shridattdudhat/Havaamaan_Yantra/README.md

# Havaamaan_Yantra
Havaamaan_Yantra AKA WeatherStation !!
