shridattdudhat/Havaamaan_Yantra/Ref/QingStation-main/doc/figures/digrams.pptx

North

South

North

South

Excitation

Direct

Echo

Distorsion

## Slide 2

North

South

North

South

## Slide 3

## Slide 4

Pitch (D)

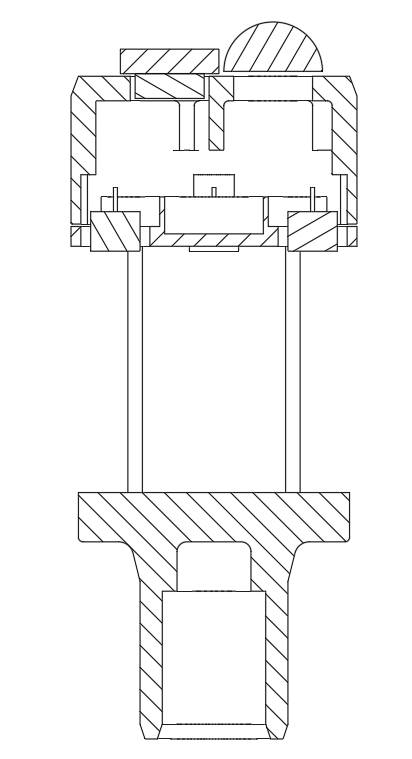
[picture p1: figure]

Silicone Glue

Transducers

α

Wind

Height
(H)

Sound travel path

B

A

Composition of motion

C

α

D

Reflector

## Slide 5

Transmitter

Receiver

Ideal Sound path

Pillars

Reflector

## Slide 6

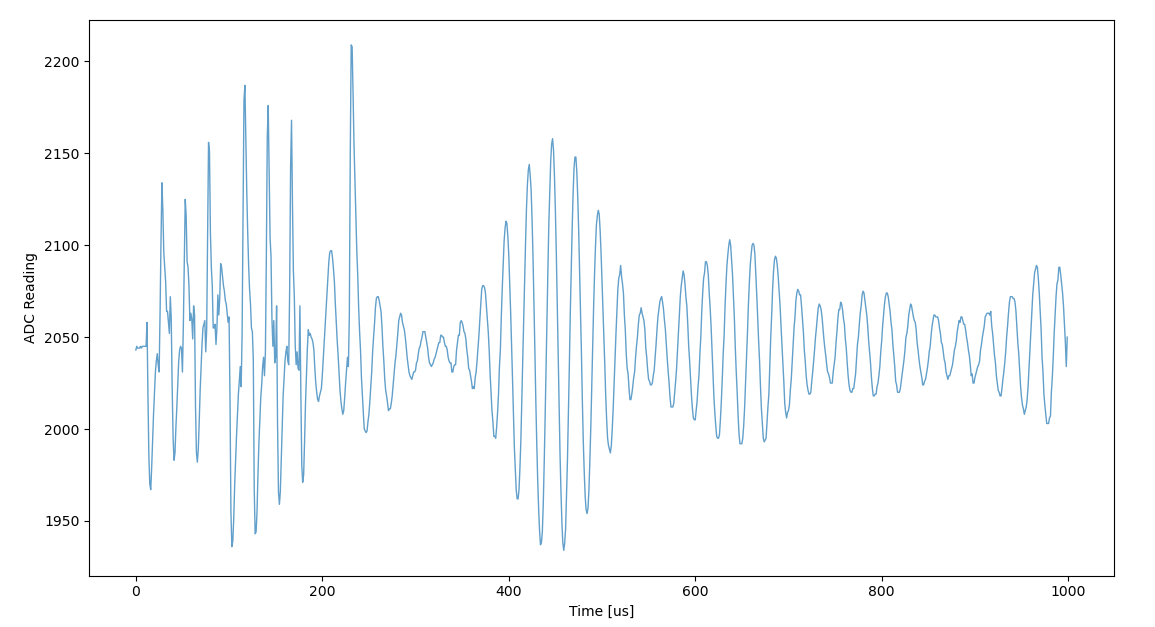
[picture p2: figure]

+

+

+

1st echo

2nd echo

3rd echo

## Slide 7

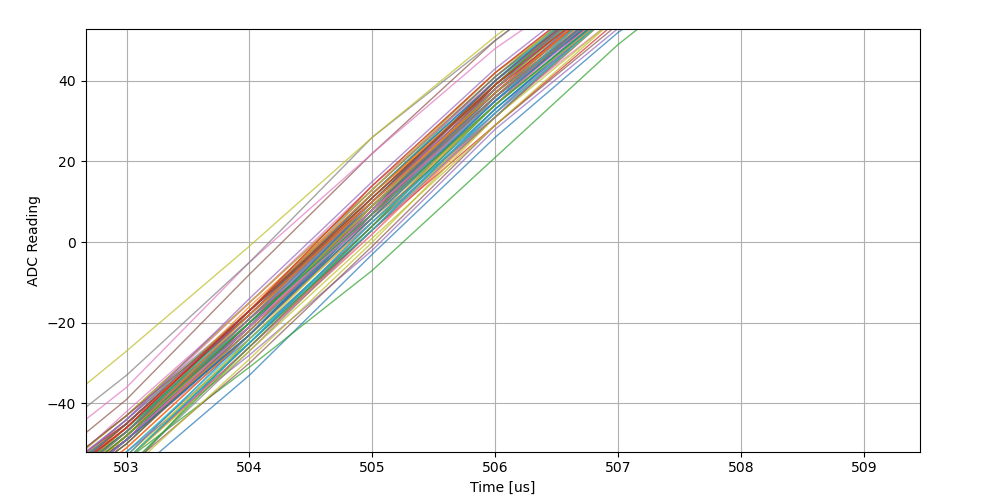
[picture p3: figure]
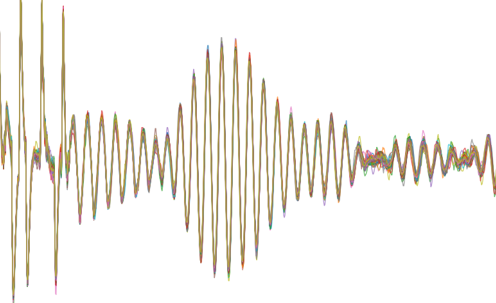
[picture p4: figure]

## Slide 8

## Slide 9

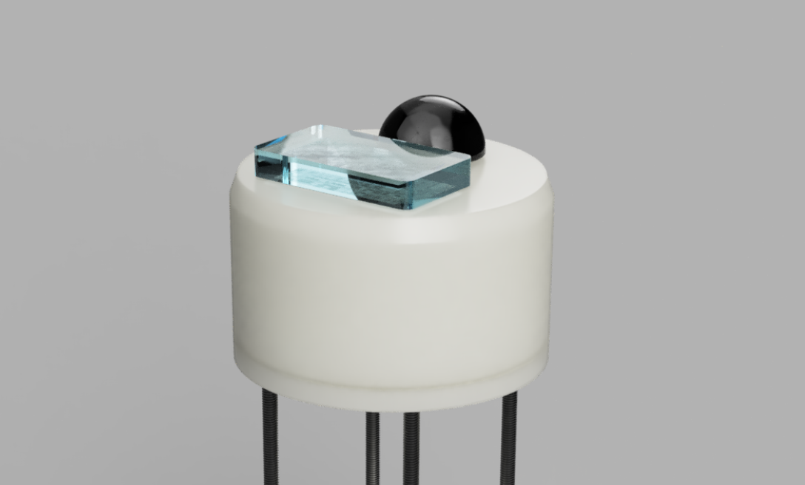
[picture p5: figure]

Rain Sensor

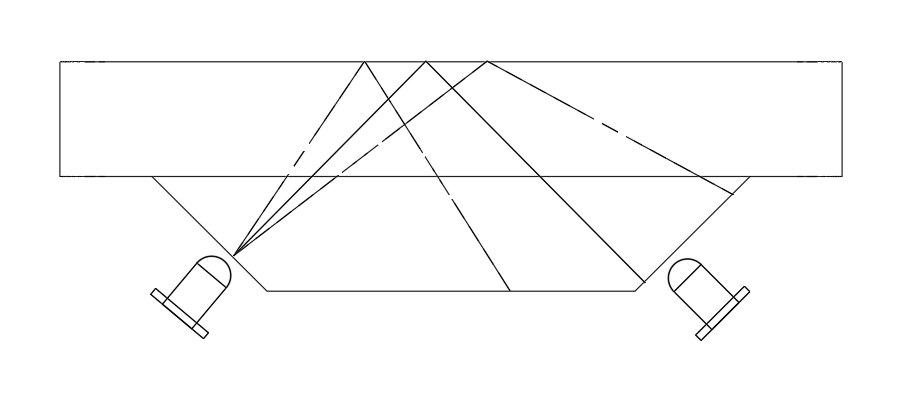
[picture p6: figure]

## Slide 10

Zone 1

Zone 2

## Slide 11

Single drops

## Slide 12

Light rain

## Slide 13

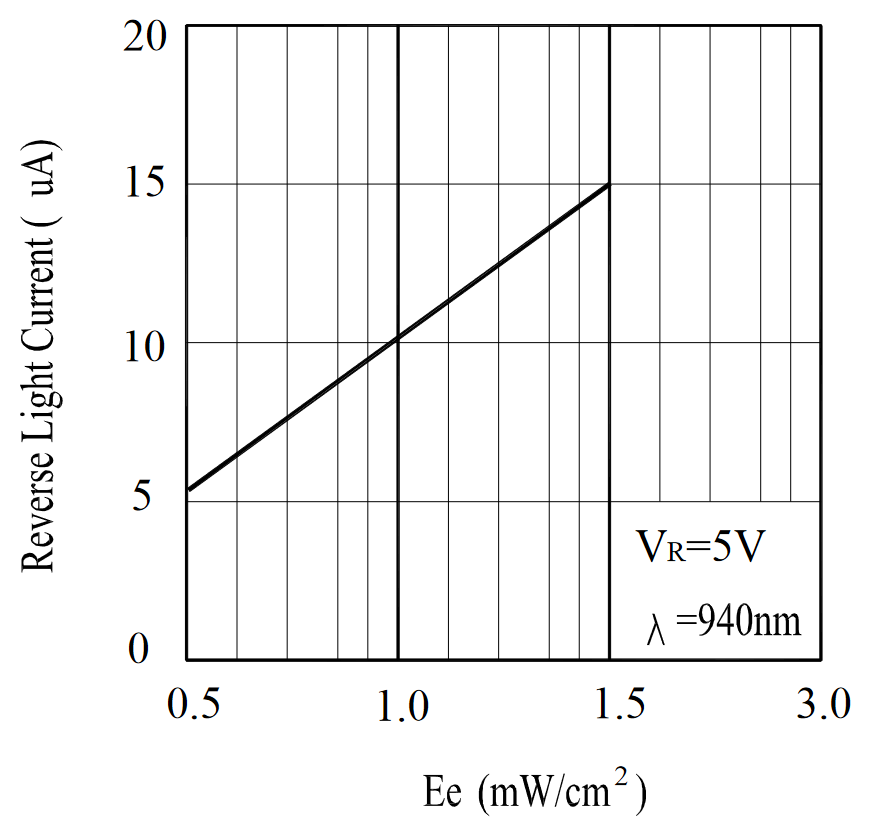
[picture p7: figure]
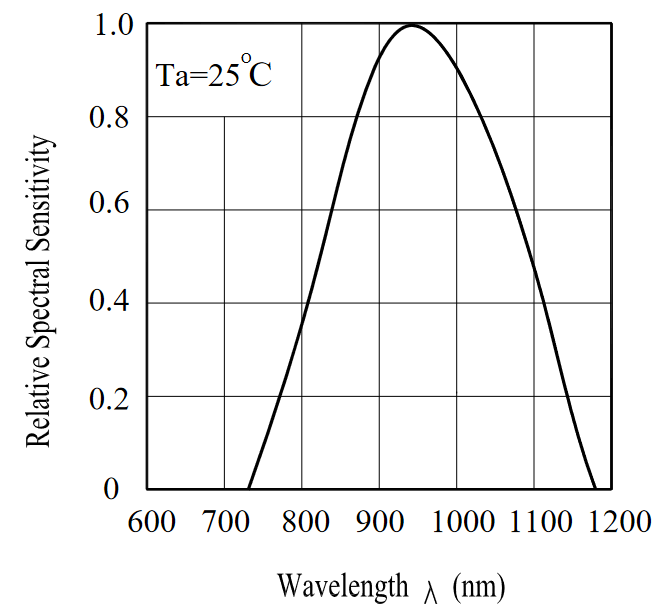
[picture p8: figure]

## Slide 14

Boot

Is App debug FM

Yes

No

SD card Boot

Key Pressed

SD Card Bin Search

Write to OTA and App

Validate App FM

Fail

No

Jump to App

Validate OTA FM

OTA != APP

Copy OTA to APP

Yes

No

Yes

## Slide 15

Bootloader
(64kB)

App Firmware
(446kB)

App tag
(2kB)

0x08000000

Flash bank 1

0x08010000

0x0807F800

OTA tag
(2kB)

OTA Firmware
(>446kB)

Reserve

0x08080000

Flash bank 2

0x08080800

?

0x0808FFFFF

## Slide 16

Initial

Type (8bit)

Firmware tag (str)

Data Pack

Type (8bit)

Pack ID (16b)

Size (16b)

Payload (N*8b)

Checksum(16b)

Close Pack

Type (8bit)

Payload (str)

Ack Pack

Type (8bit)

“pack id,true” or “pack id,false” (str)

## Slide 17

## Slide 18

## Slide 19
