shridattdudhat/Havaamaan_Yantra/Ref/QingStation-main/doc/figures/anemometer-sch.png

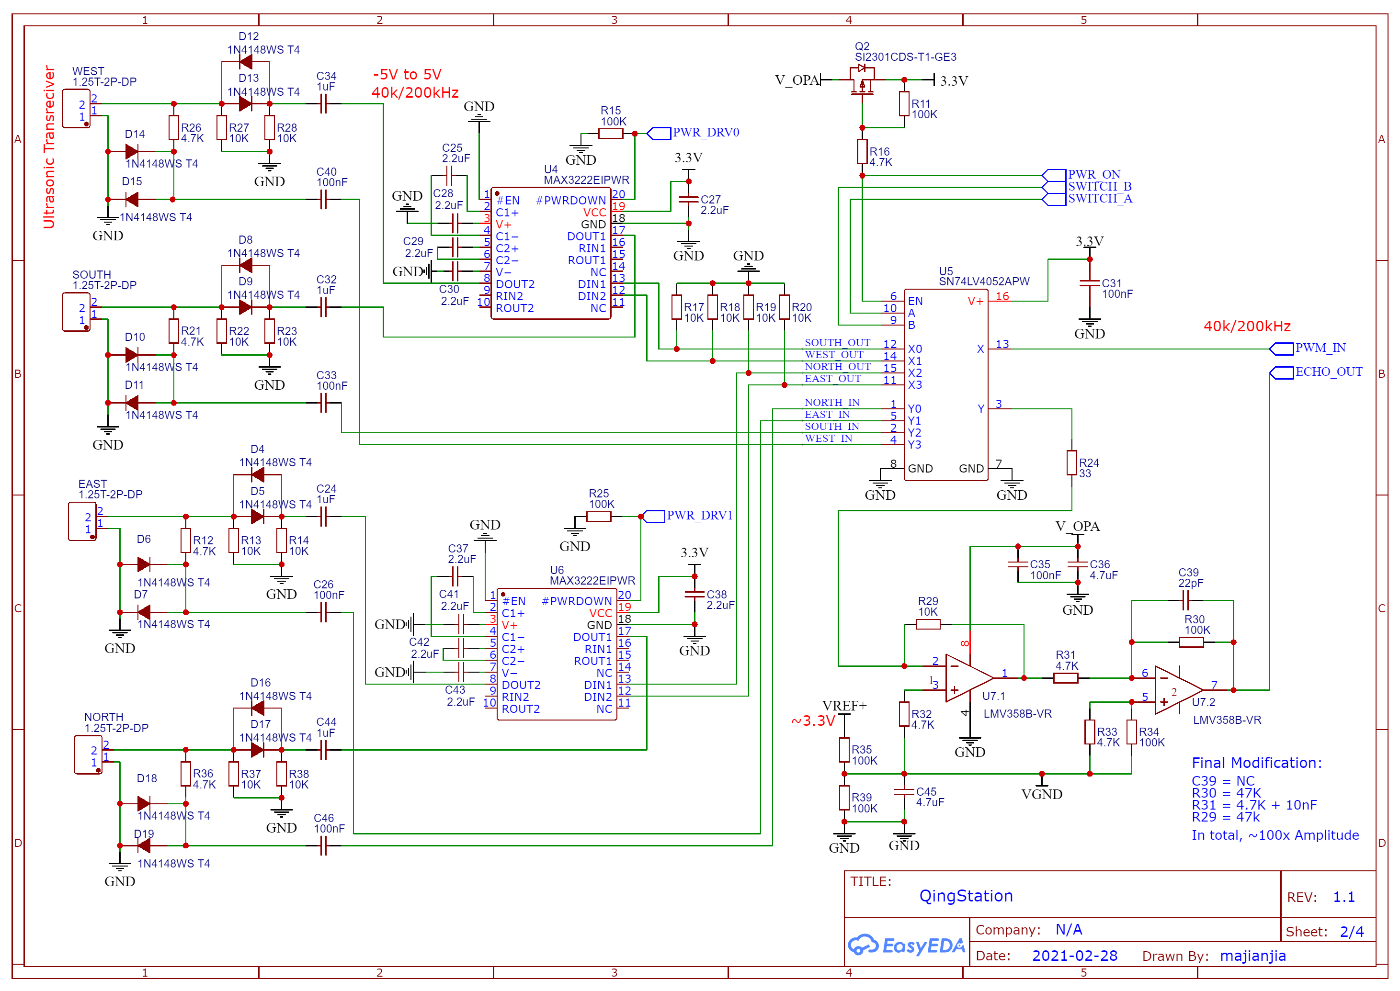
Ref/QingStation-main/doc/figures/anemometer-sch.png
