shridattdudhat/Havaamaan_Yantra/Ref/QingStation-main/doc/figures/anemometer_car_windspeed.png

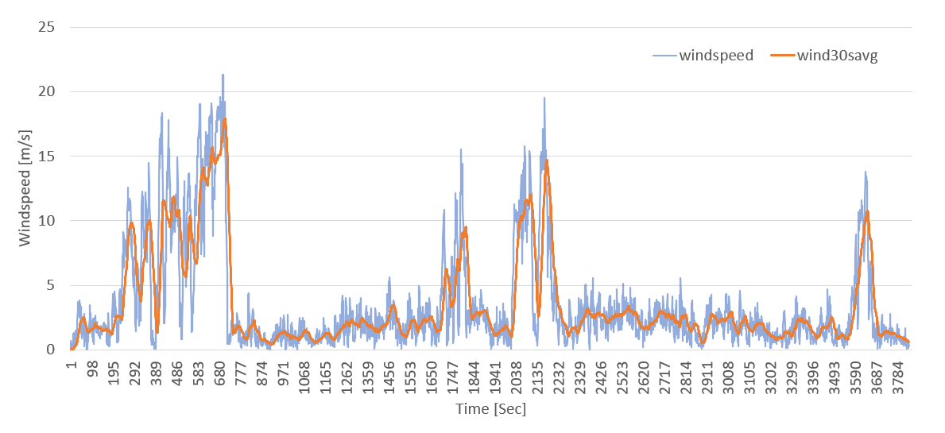
Ref/QingStation-main/doc/figures/anemometer_car_windspeed.png
