shridattdudhat/Havaamaan_Yantra/Ref/QingStation-main/doc/figures/anemometer_digital_filter_response.png

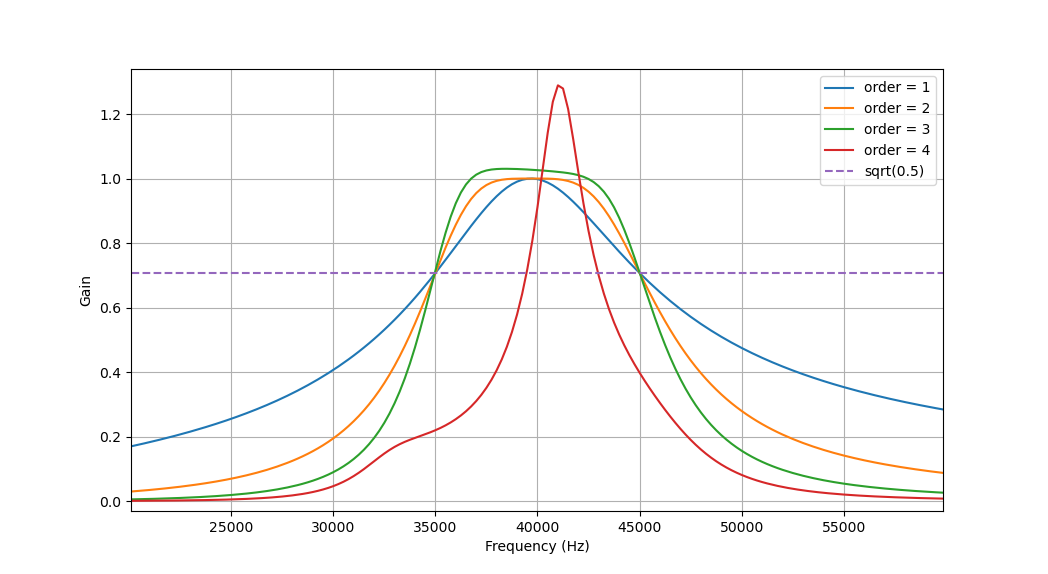
Ref/QingStation-main/doc/figures/anemometer_digital_filter_response.png
