shridattdudhat/Havaamaan_Yantra/Ref/QingStation-main/doc/figures/anemometer_excitation.png

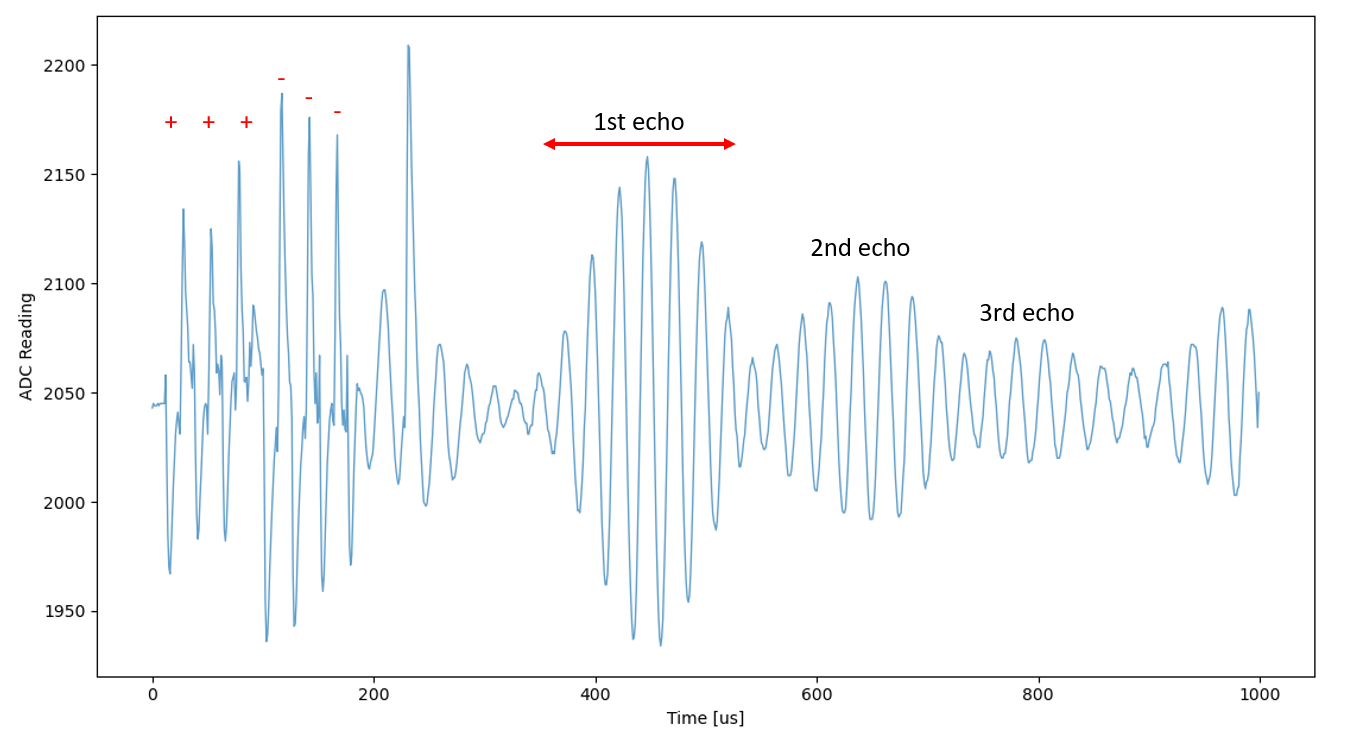
Ref/QingStation-main/doc/figures/anemometer_excitation.png
