shridattdudhat/Havaamaan_Yantra/Ref/QingStation-main/doc/figures/anemometer_final_beam.png

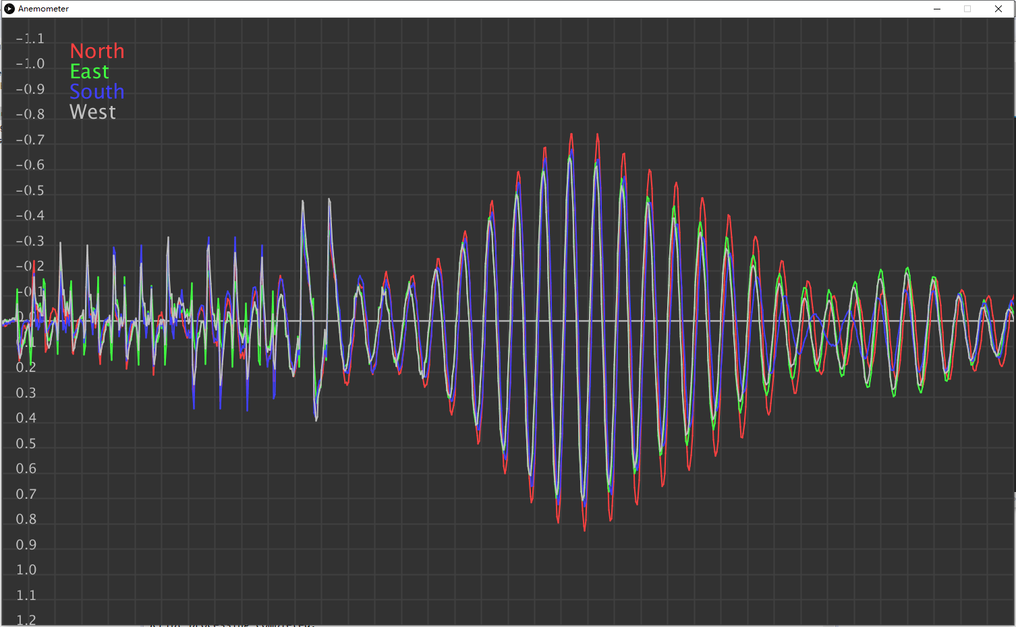
Ref/QingStation-main/doc/figures/anemometer_final_beam.png
