shridattdudhat/Havaamaan_Yantra/Ref/QingStation-main/doc/figures/anemometer_gnss_vs_wind.png

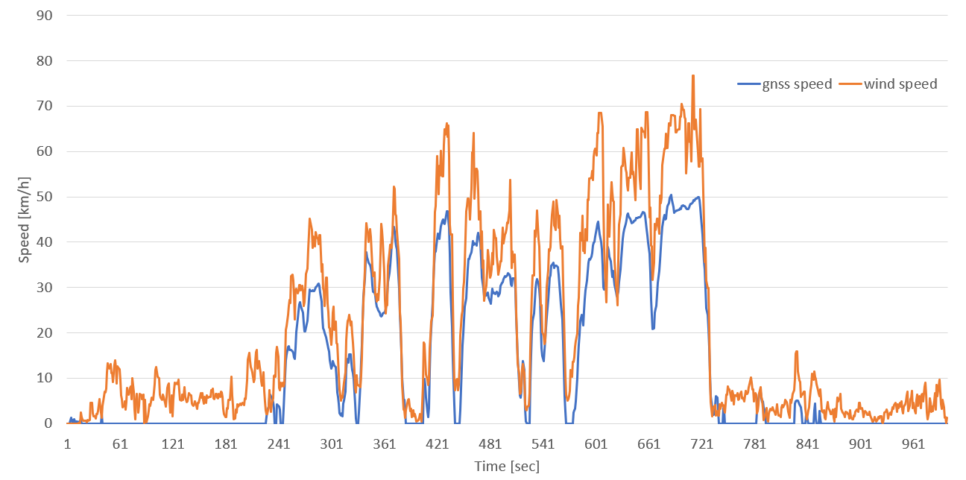
Ref/QingStation-main/doc/figures/anemometer_gnss_vs_wind.png
