shridattdudhat/Havaamaan_Yantra/Ref/QingStation-main/doc/figures/anemometer_keep_out_zone.png

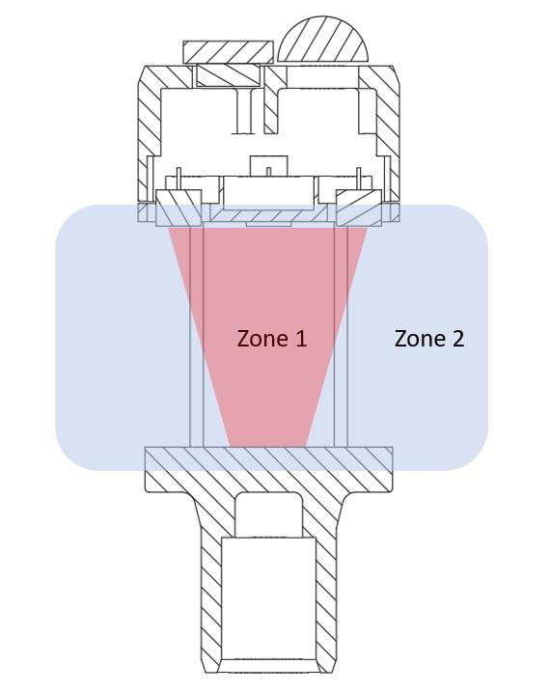
Ref/QingStation-main/doc/figures/anemometer_keep_out_zone.png
