shridattdudhat/Havaamaan_Yantra/Ref/QingStation-main/doc/figures/anemometer_motorway_rain.png

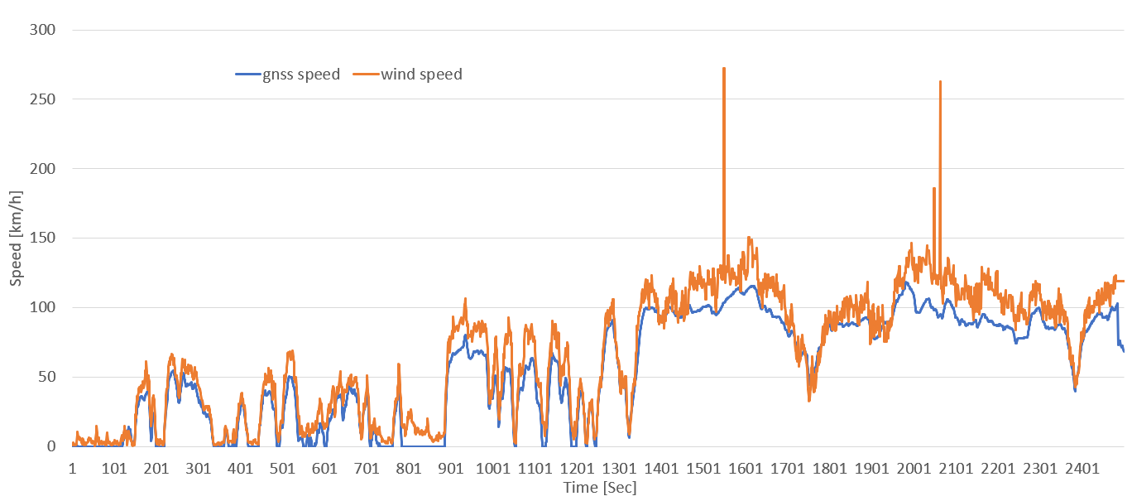
Ref/QingStation-main/doc/figures/anemometer_motorway_rain.png
