shridattdudhat/Havaamaan_Yantra/Ref/QingStation-main/doc/figures/anemometer_mse_threshold.png

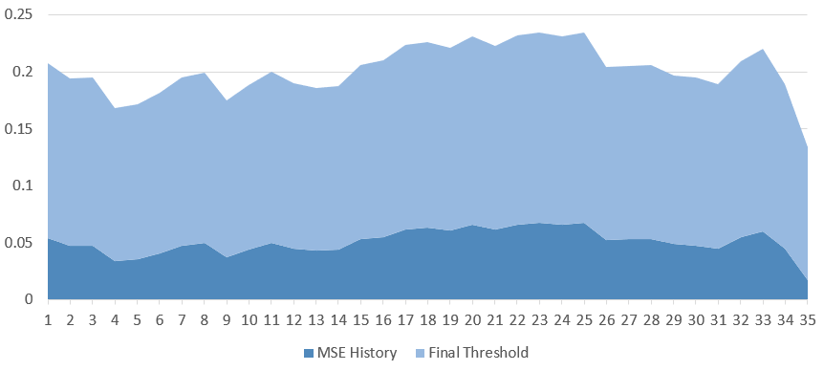
Ref/QingStation-main/doc/figures/anemometer_mse_threshold.png
