shridattdudhat/Havaamaan_Yantra/Ref/QingStation-main/doc/figures/anemometer_multiple_sound_path.png

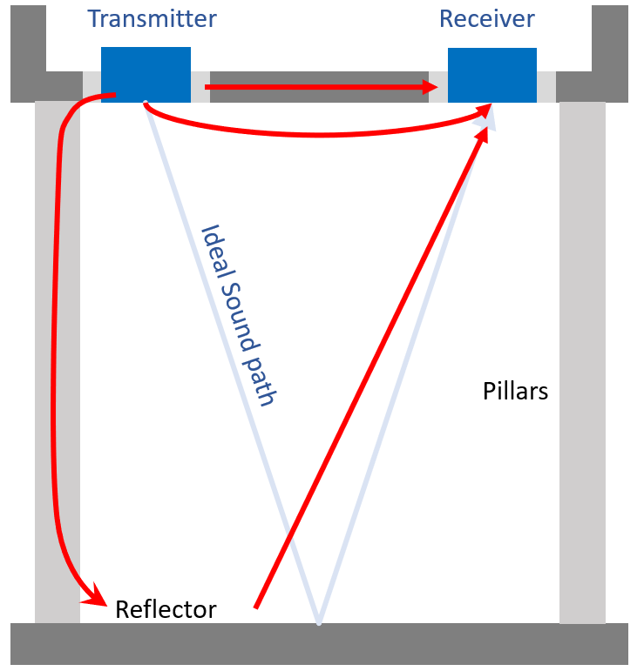
Ref/QingStation-main/doc/figures/anemometer_multiple_sound_path.png
