shridattdudhat/Havaamaan_Yantra/Ref/QingStation-main/doc/figures/anemometer_noise.png

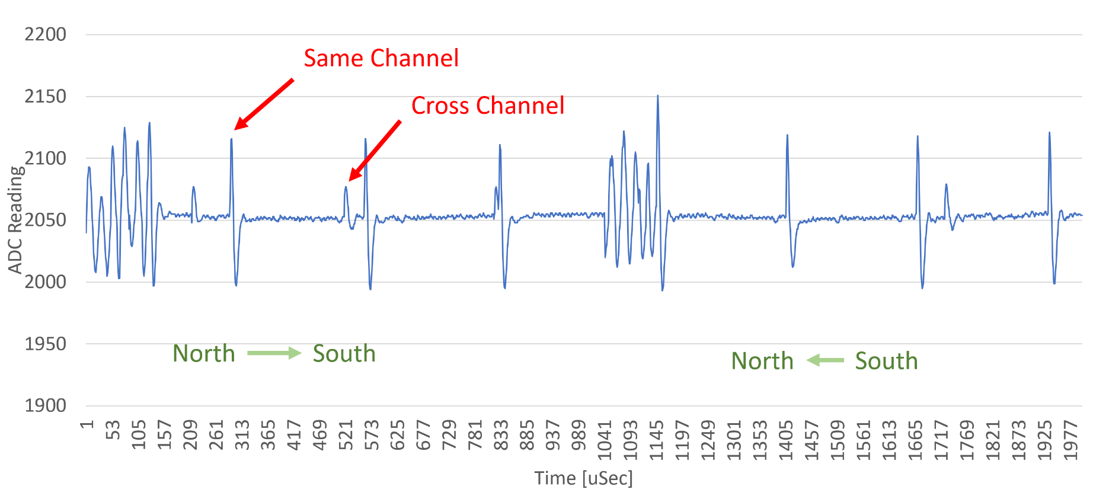
Ref/QingStation-main/doc/figures/anemometer_noise.png
