shridattdudhat/Havaamaan_Yantra/Ref/QingStation-main/doc/figures/anemometer_processing3_demo.gif

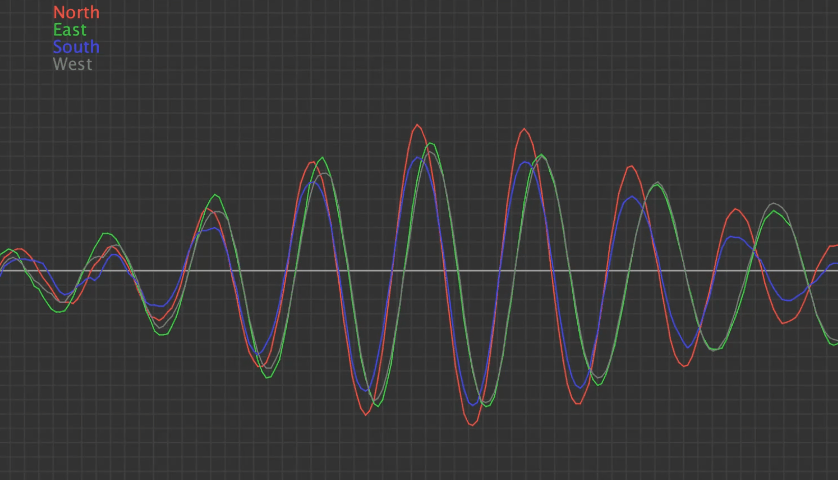
Ref/QingStation-main/doc/figures/anemometer_processing3_demo.gif
