shridattdudhat/Havaamaan_Yantra/Ref/QingStation-main/doc/figures/anemometer_signal_distorsion.png

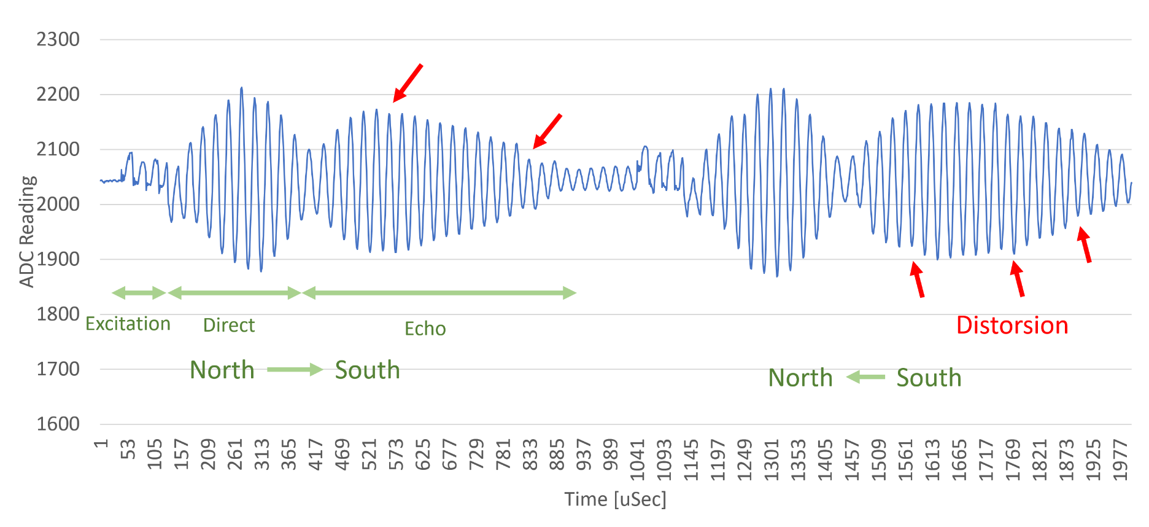
Ref/QingStation-main/doc/figures/anemometer_signal_distorsion.png
