shridattdudhat/Havaamaan_Yantra/Ref/QingStation-main/doc/figures/anemometer_speed_of_sound.png

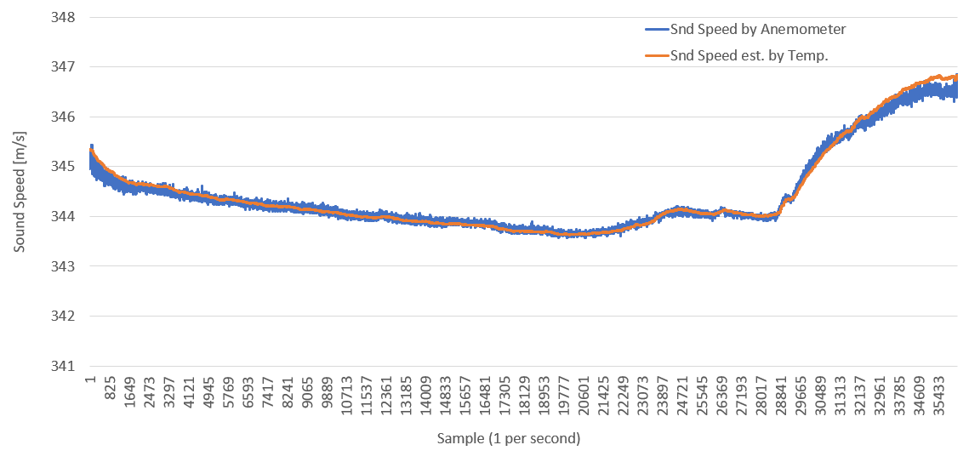
Ref/QingStation-main/doc/figures/anemometer_speed_of_sound.png
