shridattdudhat/Havaamaan_Yantra/Ref/QingStation-main/doc/figures/anemometer_wifi_power_burst2.png

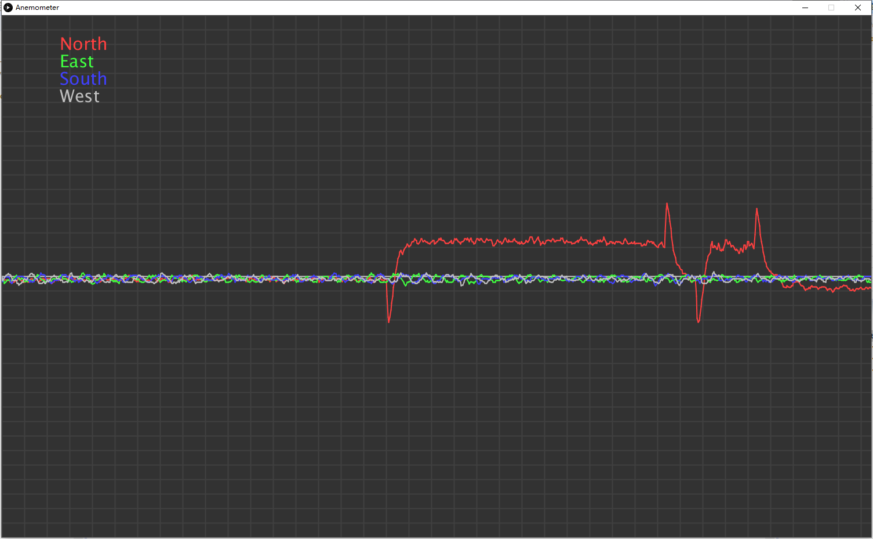
Ref/QingStation-main/doc/figures/anemometer_wifi_power_burst2.png
