shridattdudhat/Havaamaan_Yantra/Ref/QingStation-main/doc/figures/anemometer_wifi_power_burst.png

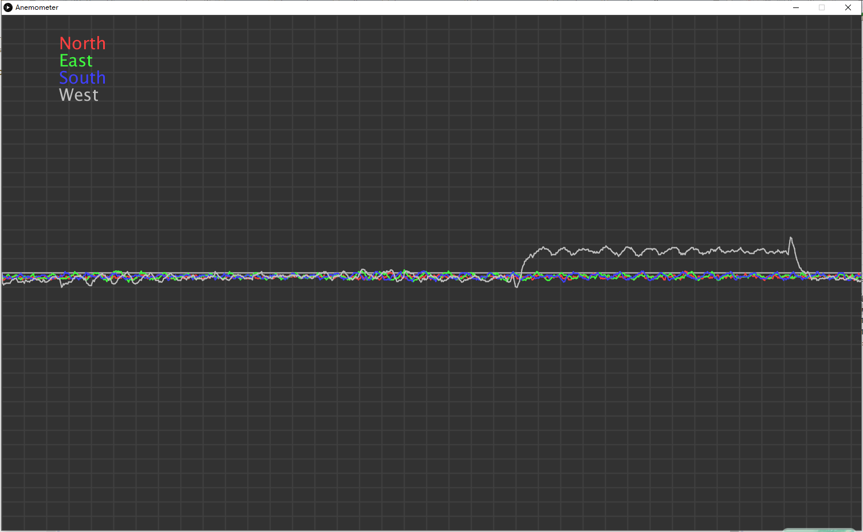
Ref/QingStation-main/doc/figures/anemometer_wifi_power_burst.png
