shridattdudhat/Havaamaan_Yantra/Ref/QingStation-main/doc/figures/anemometer_zero_offset_example.png

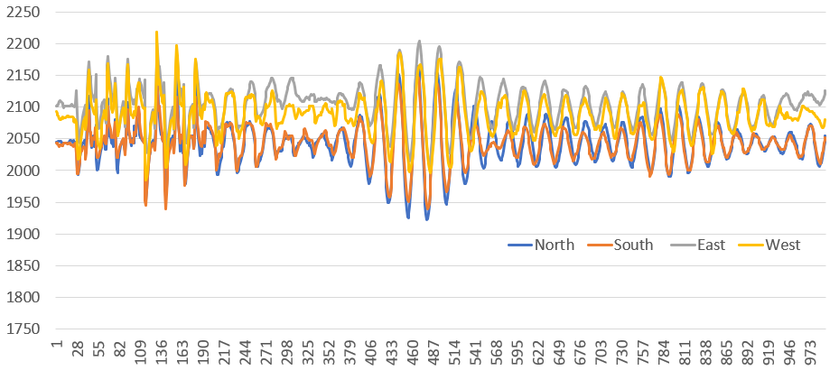
Ref/QingStation-main/doc/figures/anemometer_zero_offset_example.png
