shridattdudhat/Havaamaan_Yantra/Ref/QingStation-main/doc/figures/anemometer_zero_point.png

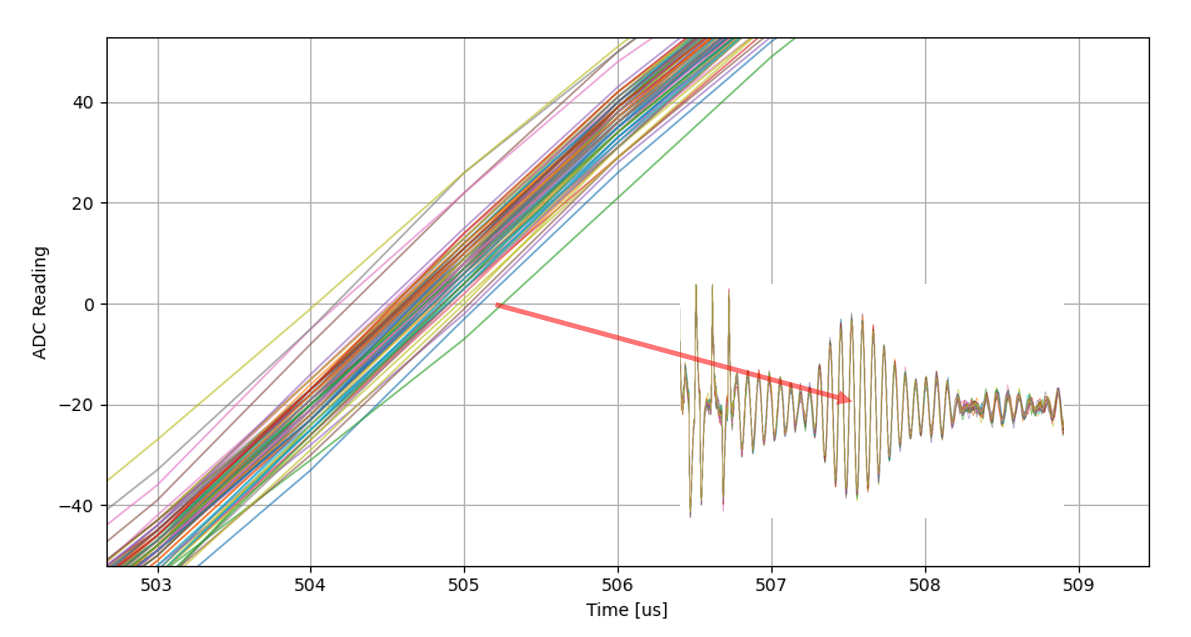
Ref/QingStation-main/doc/figures/anemometer_zero_point.png
