shridattdudhat/Havaamaan_Yantra/Ref/QingStation-main/doc/figures/as3935_noise.png

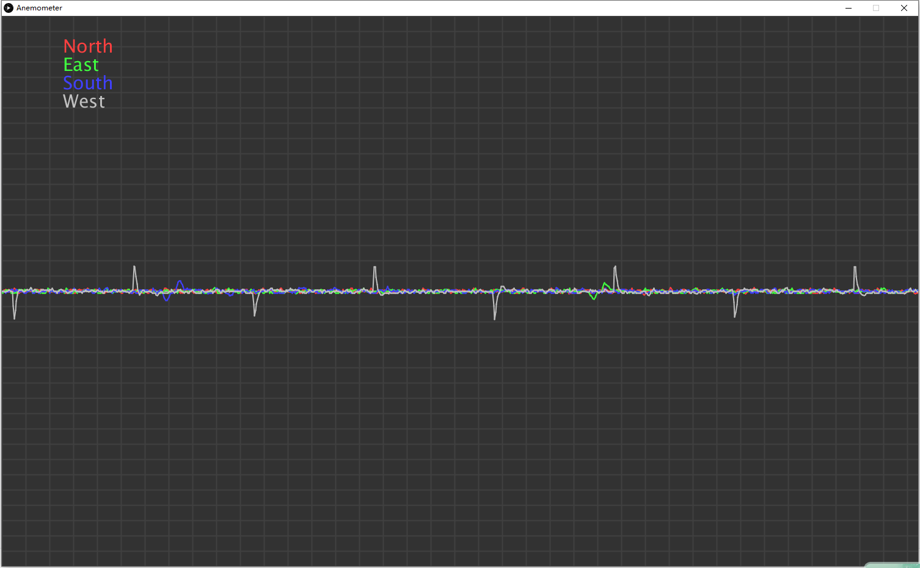
Ref/QingStation-main/doc/figures/as3935_noise.png
