shridattdudhat/Havaamaan_Yantra/Ref/QingStation-main/doc/figures/first_pulse_received.jpg

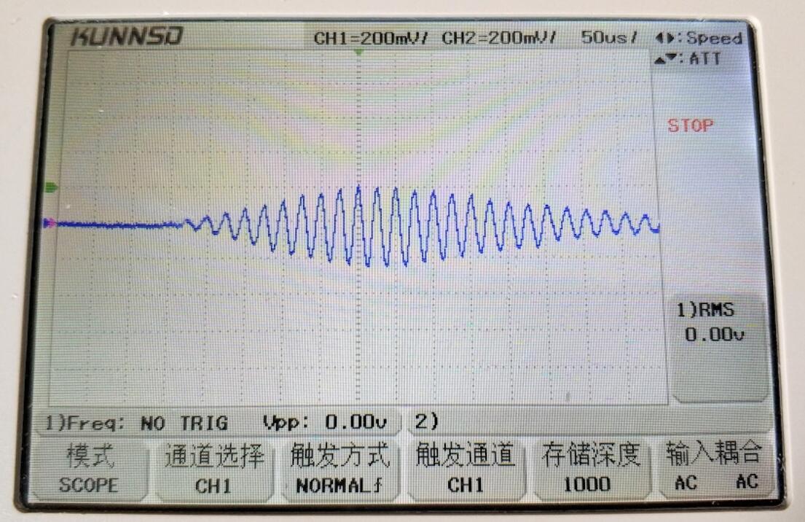
Ref/QingStation-main/doc/figures/first_pulse_received.jpg
