shridattdudhat/Havaamaan_Yantra/Ref/QingStation-main/doc/figures/imu_noise.png

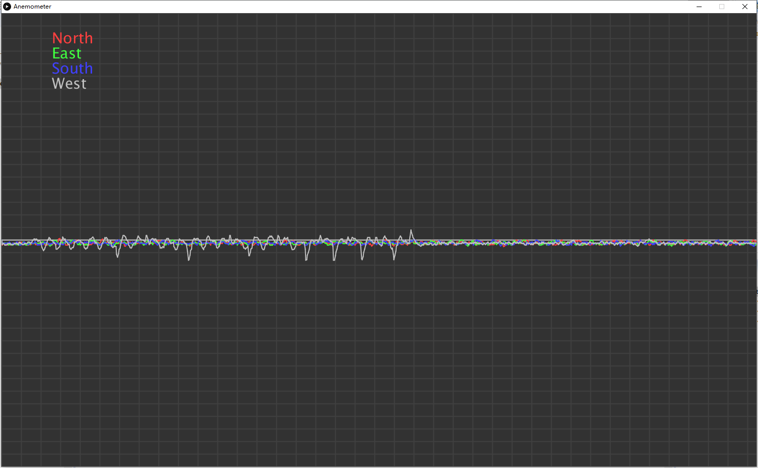
Ref/QingStation-main/doc/figures/imu_noise.png
