shridattdudhat/Havaamaan_Yantra/Ref/QingStation-main/doc/figures/max3232_driver_noise.jpg

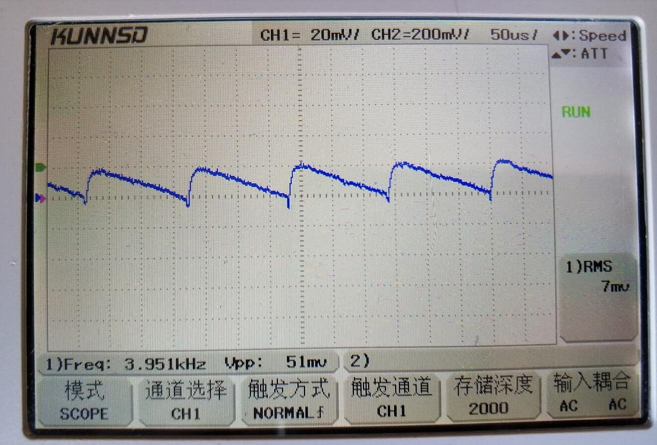
Ref/QingStation-main/doc/figures/max3232_driver_noise.jpg
