shridattdudhat/Havaamaan_Yantra/Ref/QingStation-main/doc/figures/ota_flash_allocation.png

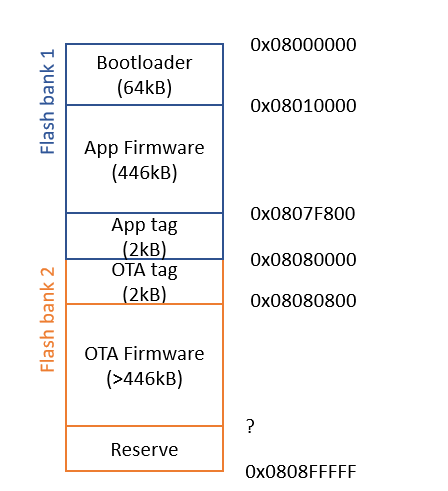
Ref/QingStation-main/doc/figures/ota_flash_allocation.png
