shridattdudhat/Havaamaan_Yantra/Ref/QingStation-main/doc/figures/ota_messages.png

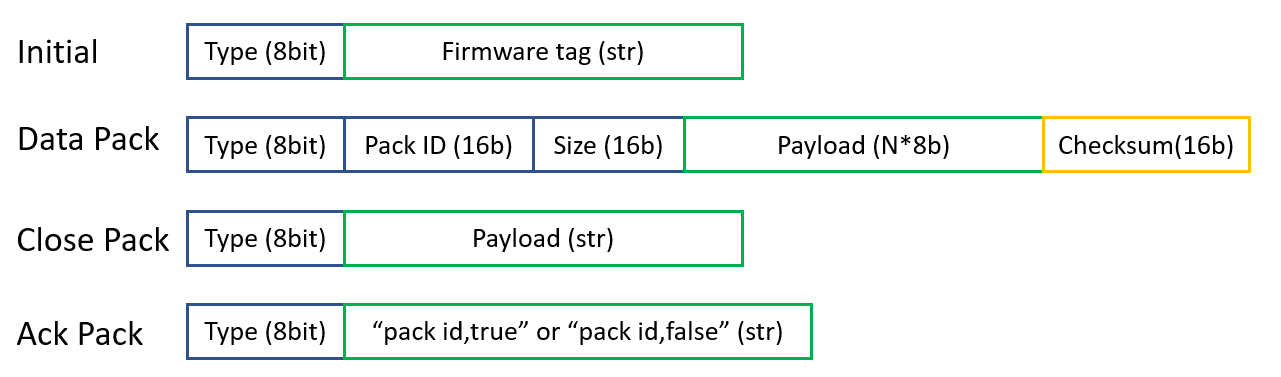
Ref/QingStation-main/doc/figures/ota_messages.png
