shridattdudhat/Havaamaan_Yantra/Ref/QingStation-main/doc/figures/QingStation-CDF2.png

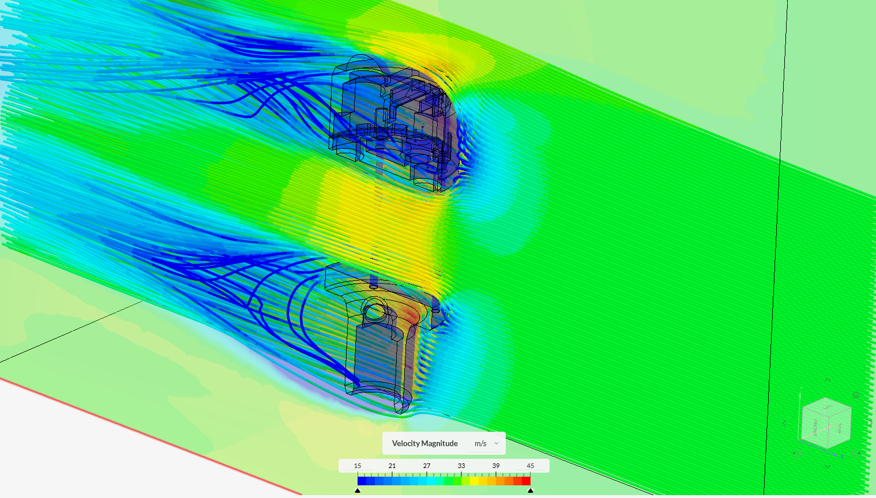
Ref/QingStation-main/doc/figures/QingStation-CDF2.png
