shridattdudhat/Havaamaan_Yantra/Ref/QingStation-main/doc/figures/QingStation-CDF.png

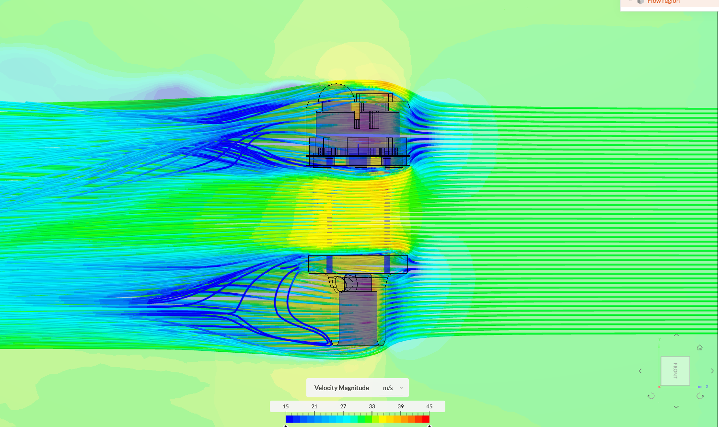
Ref/QingStation-main/doc/figures/QingStation-CDF.png
