shridattdudhat/Havaamaan_Yantra/Ref/QingStation-main/doc/figures/qingstation-render1.png

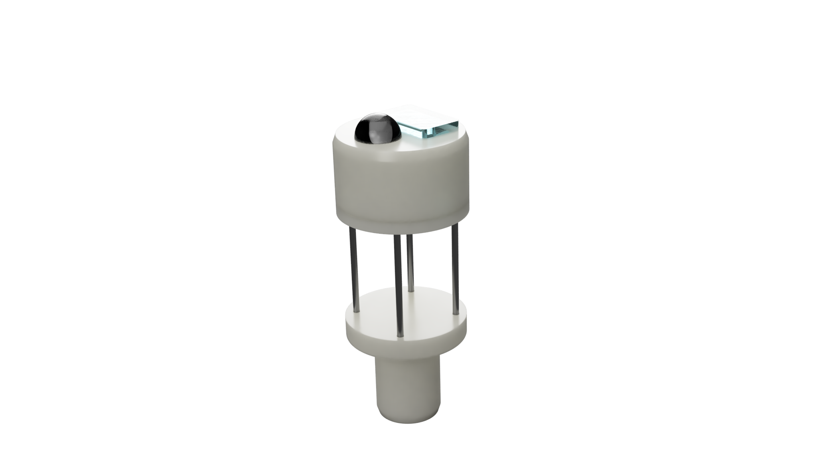
Ref/QingStation-main/doc/figures/qingstation-render1.png
