shridattdudhat/Havaamaan_Yantra/Ref/QingStation-main/doc/figures/qingstation-render2.PNG

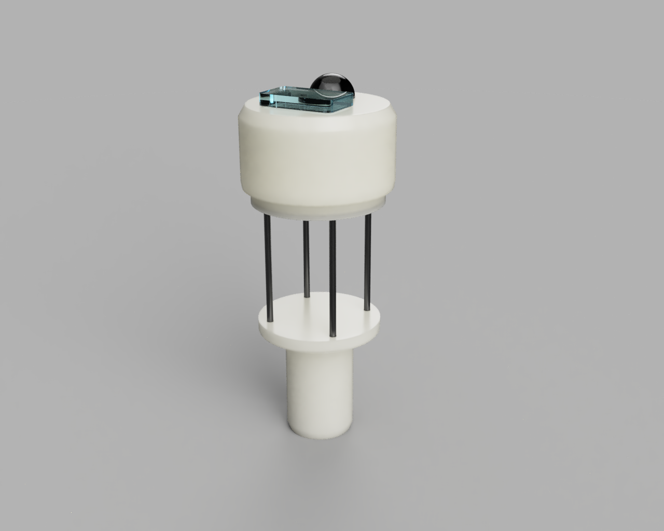
Ref/QingStation-main/doc/figures/qingstation-render2.PNG
