shridattdudhat/Havaamaan_Yantra/Ref/QingStation-main/doc/figures/rain_lens2.jpg

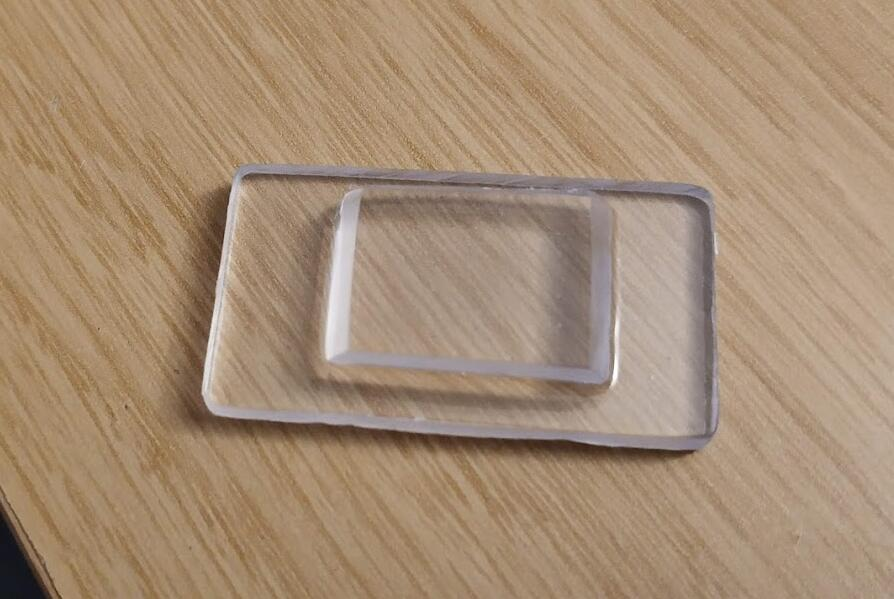
Ref/QingStation-main/doc/figures/rain_lens2.jpg
