shridattdudhat/Havaamaan_Yantra/Ref/QingStation-main/doc/figures/rain_lens.jpg

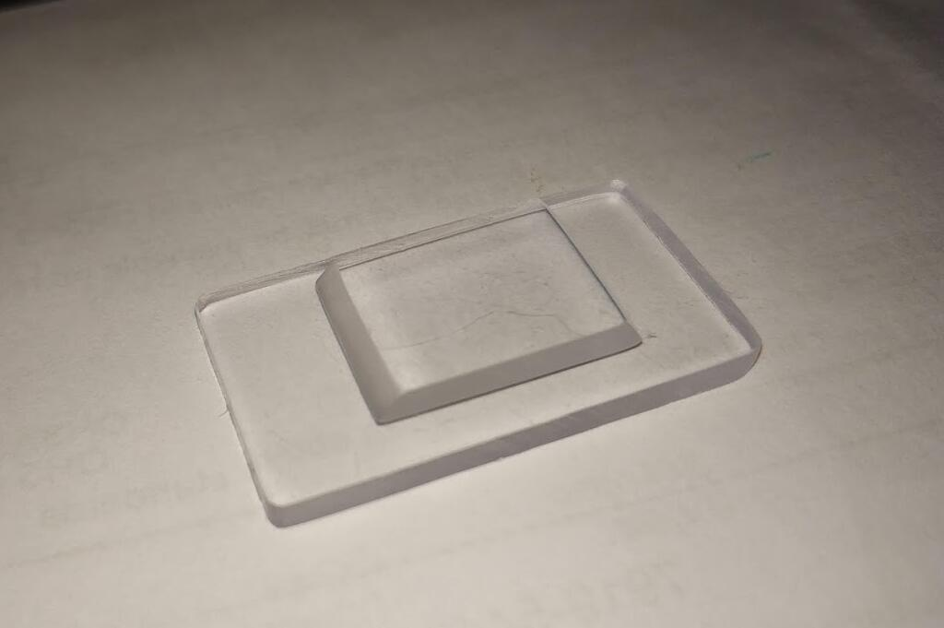
Ref/QingStation-main/doc/figures/rain_lens.jpg
