shridattdudhat/Havaamaan_Yantra/Ref/QingStation-main/doc/figures/rain_pd204 black.png

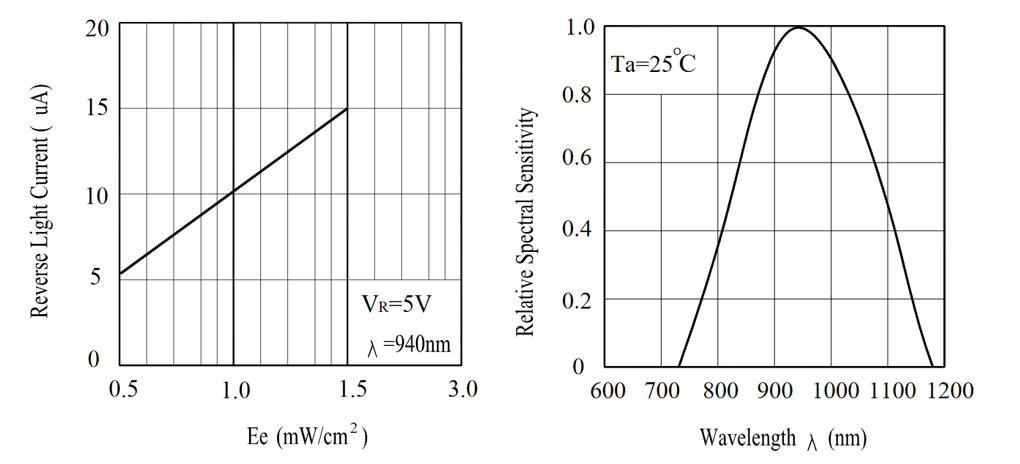
Ref/QingStation-main/doc/figures/rain_pd204 black.png
