shridattdudhat/Havaamaan_Yantra/Ref/QingStation-main/doc/figures/rain_realrain.png

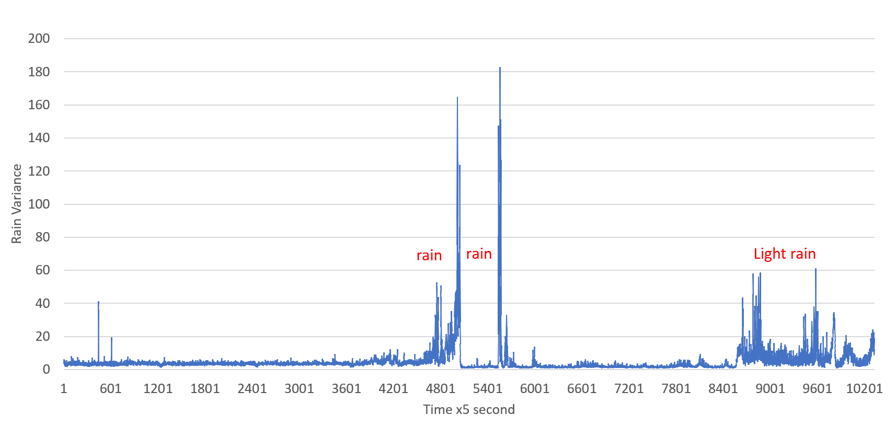
Ref/QingStation-main/doc/figures/rain_realrain.png
