shridattdudhat/Havaamaan_Yantra/Ref/QingStation-main/doc/figures/rain_schmatic.png

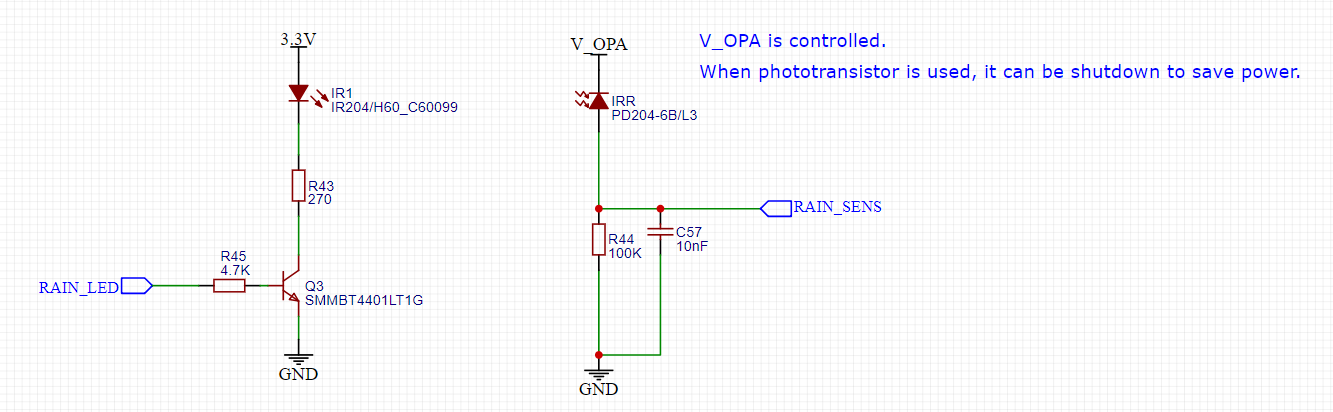
Ref/QingStation-main/doc/figures/rain_schmatic.png
