shridattdudhat/Havaamaan_Yantra/Ref/QingStation-main/doc/figures/rain_weather_forcast.jpg

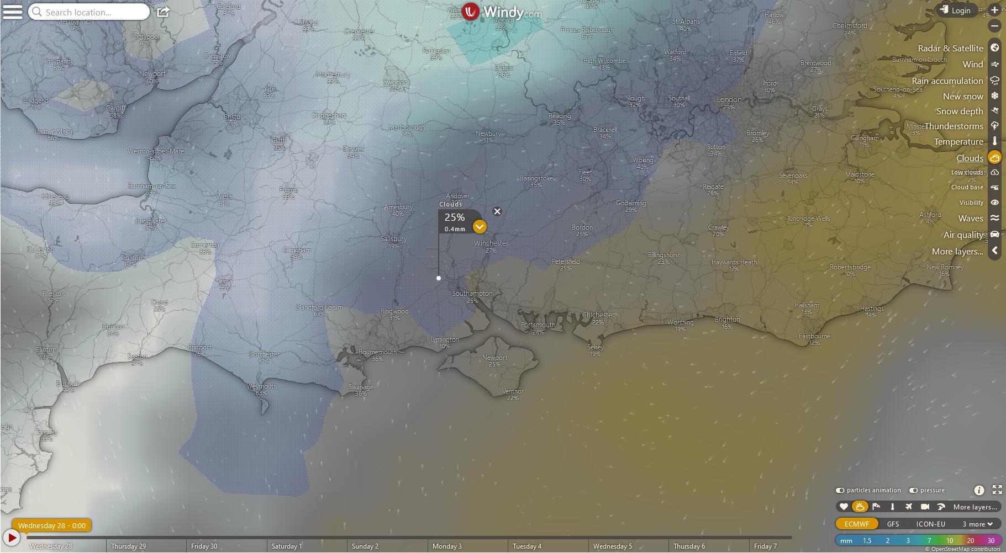
Ref/QingStation-main/doc/figures/rain_weather_forcast.jpg
