shridattdudhat/Havaamaan_Yantra/Ref/QingStation-main/doc/figures/ultrasonic_anemometer_principle.png

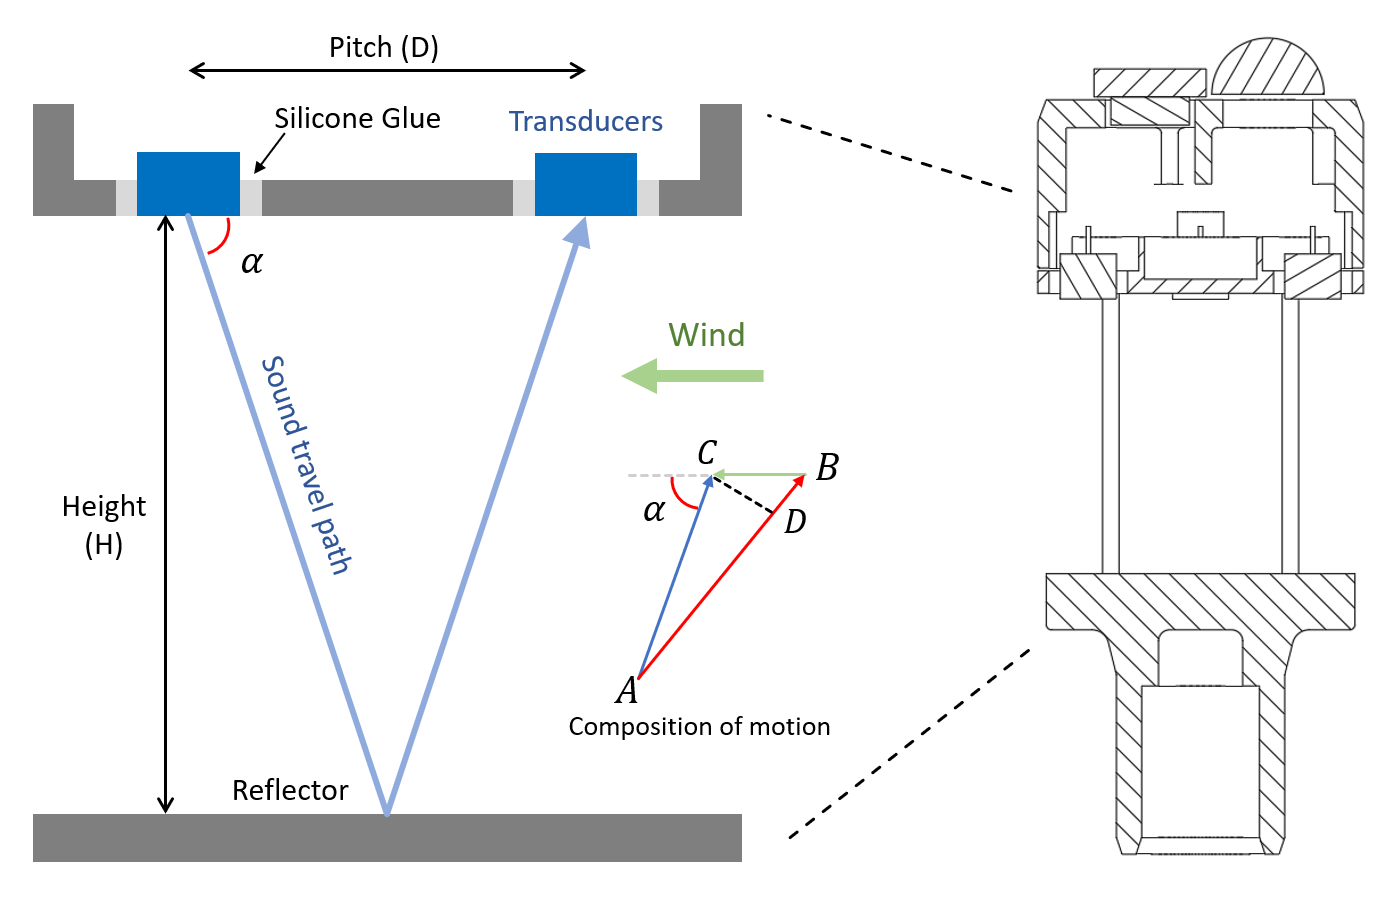
Ref/QingStation-main/doc/figures/ultrasonic_anemometer_principle.png
