shridattdudhat/Havaamaan_Yantra/Ref/QingStation-main/PCB/v1.1/fabrication/BOM.csv

ID | Name | Designator | Footprint | Quantity | Manufacturer Part | Manufacturer | Supplier | Supplier Part | LCSC Assembly | Assembly Type | Paste Type | JLCPCB SMD
1 | INDUCTORMA5532 | ANT | INDUCTOR_COILCRAFT_MA5532-AE | 1
2 | B2B-XH-A-GU | BAT | CONN-TH_B2B-XH-A-GU | 1 | B2B-XH-A-GU | JST Sales America | LCSC | C265283 | Yes
3 | 1uF | C1,C2 | C0402 | 2 | CL05A105KA5NQNC | SAMSUNG | LCSC | C52923 | Yes |  |  | Yes
4 | 10pF | C3,C5,C6,C7 | C0402 | 4 | CL05C100JB5NNNC | SAMSUNG | LCSC | C32949 | Yes |  |  | Yes
5 | 10nF | C9 | C0402 | 1 | CL05B103KB5NNNC | SAMSUNG | LCSC | C15195 | Yes |  |  | Yes
6 | 1uF | C11,C13,C22,C54 | C0402 | 4 | CL05A105KA5NQNC | SAMSUNG | LCSC | C52923 | Yes |  |  | Yes
7 | 100uF | C12 | CAP-SMD_L3.5-W2.8 | 1 | TAJB107K006RNJ | AVX | LCSC | C16133 | Yes |  |  | Yes
8 | 4.7uF | C4,C16 | C0603 | 2 | CL10A475KO8NNNC | SAMSUNG | LCSC | C19666 | Yes |  |  | Yes
9 | 100nF | C8,C17,C18,C19 | C0402 | 4 | CL05B104KO5NNNC | SAMSUNG | LCSC | C1525 | Yes |  |  | Yes
10 | 1uF | C24,C32,C34,C44 | C0603 | 4 | CL10A105KB8NNNC | SAMSUNG | LCSC | C15849 | Yes | smtWeld | base | Yes
11 | 2.2uF | C25,C27,C28,C29,C30,C37,C38,C41,C42,C43 | C0603 | 10 | CL10A225KO8NNNC | SAMSUNG | LCSC | C23630 | Yes | smtWeld | base | Yes
12 | 100nF | C10,C21,C26,C33,C35,C40,C46,C47,C50,C51,C52,C53 | C0402 | 12 | CL05B104KO5NNNC | SAMSUNG | LCSC | C1525 | Yes |  |  | Yes
13 | 100nF | C31 | C0603 | 1 | CC0603KRX7R9BB104 | YAGEO | LCSC | C14663 | Yes |  |  | Yes
14 | 4.7uF | C36 | C0603 | 1 | CL10A475KO8NNNC | SAMSUNG | LCSC | C19666 | Yes | smtWeld | base | Yes
15 | 22pF | C39 | C0402 | 1 | 0402CG220J500NT | FH | LCSC | C1555 | Yes |  |  | Yes
16 | 4.7uF | C45 | C0402 | 1 | CL05A475MP5NRNC | SAMSUNG | LCSC | C23733 | Yes | smtWeld | base | Yes
17 | 10uF | C55 | C0603 | 1 | CL10A106KP8NNNC | SAMSUNG | LCSC | C19702 | Yes | smtWeld | base | Yes
18 | 1nF | C56 | C0402 | 1 | 0402B102K500NT | FH | LCSC | C1523 | Yes | smtWeld | base | Yes
19 | 10nF | C15,C23,C57 | C0402 | 3 | CL05B103KB5NNNC | SAMSUNG | LCSC | C15195 | Yes |  |  | Yes
20 | NUP1105LT1G | D1 | SOT-23-3_L2.9-W1.3-P1.90-LS2.4-BR | 1 | NUP1105LT1G | ON | LCSC | C130455 | Yes |  |  | Yes
21 | SN65220DBVR | D2 | SOT-23-6_L2.9-W1.6-P0.95-LS2.8-BR | 1 | SN65220DBVR | TI | LCSC | C21787 | Yes |  |  | Yes
22 | B5819W_C8598 | D3 | SOD-123_L2.8-W1.8-LS3.7-RD | 1 | B5819W | CJ | LCSC | C8598 | Yes |  |  | Yes
23 | 1N4148WS T4 | D4,D5,D6,D7,D8,D9,D10,D11,D12,D13,D14,D15,D16,D17,D18,D19 | SOD-323_L1.8-W1.3-LS2.5-RD | 16 | 1N4148WS T4 | CJ | LCSC | C2128 | Yes |  |  | Yes
24 | 2328702-8 | DEBUG | 23287028 | 1
25 | 1.25T-2P-DP | EAST,NORTH,SOUTH,WEST | CONN-TH_2P-P1.25_1.25T-2P-DP | 4 | 1.25T-2P-DP | HRO | LCSC | C145940 | Yes | manualWeld | expand
26 | 1.25T-1-4A | I2C | CONN-TH_1.25T-1-4A | 1 | 1.25T-1-4A | BOOMELE | LCSC | C10821 | Yes
27 | IR204/H60_C60099 | IR1 | LED-TH_BD3.0-P2.54-FD | 1 | IR204/H60 | EVERLIGHT | LCSC | C60099 | Yes
28 | PD204-6B/L3 | IRR | LED-TH_BD3.1-P2.54-FD | 1 | PD204-6B/L3 | Everlight Elec | LCSC | C182237 | Yes | manualWeld | expand
29 | 19-217/BHC-ZL1M2RY/3T | LED1 | LED0603-R-RD | 1 | 19-217/BHC-ZL1M2RY/3T | EVERLIGHT | LCSC | C72041 | Yes |  |  | Yes
30 | KT-0603R | LED2 | LED0603-R-RD | 1 | KT-0603R | KENTO | LCSC | C2286 | Yes | smtWeld | base | Yes
31 | MP34DT06JTR | MIC1 | MIC-SMD_5P-L3.0-W4.0-P0.85-BL | 1 | MP34DT06JTR | STMicroelectronics | LCSC | C503097
32 | SI2301CDS-T1-GE3 | Q1,Q2 | SOT-23-3_L3.0-W1.7-P0.95-LS2.9-BR | 2 | SI2301CDS-T1-GE3 | VISHAY | LCSC | C10487 | Yes |  |  | Yes
33 | SMMBT4401LT1G | Q3 | SOT-23-3_L2.9-W1.3-P1.90-LS2.4-BR | 1 | SMMBT4401LT1G | ON Semicon | LCSC | C231273 | Yes |  |  | Yes
34 | 120 | R1 | R0603 | 1 | 0603WAF1200T5E | UniOhm | LCSC | C22787 | Yes |  |  | Yes
35 | 10K | R2 | R0402 | 1 | 0402WGF1002TCE | UniOhm | LCSC | C25744 | Yes |  |  | Yes
36 | 100K | R3 | R0402 | 1 | 0402WGF1003TCE | UniOhm | LCSC | C25741 | Yes |  |  | Yes
37 | 33 | R4,R5 | R0402 | 2 | 0402WGF330JTCE | UniOhm | LCSC | C25105 | Yes |  |  | Yes
38 | 1K | R6,R7 | R0603 | 2 | 0603WAF1001T5E | UniOhm | LCSC | C21190 | Yes |  |  | Yes
39 | 100K | R8,R9,R11,R15,R25,R30,R34,R35,R39,R44 | R0402 | 10 | 0402WGF1003TCE | UniOhm | LCSC | C25741 | Yes |  |  | Yes
40 | 0 | R10 | R0402 | 1 | RC0402JR-070RL | YAGEO | LCSC | C60485
41 | 4.7K | R12,R16,R21,R26,R31,R32,R33,R36,R40,R45 | R0402 | 10 | 0402WGF4701TCE | UniOhm | LCSC | C25900 | Yes |  |  | Yes
42 | 10K | R13,R14,R17,R18,R19,R20,R22,R23,R27,R28,R29,R37,R38,R41,R42 | R0402 | 15 | 0402WGF1002TCE | UniOhm | LCSC | C25744 | Yes |  |  | Yes
43 | 33 | R24 | R0402 | 1 | 0402WGF330JTCE | UniOhm | LCSC | C25105 | Yes | smtWeld | base | Yes
44 | 270 | R43 | R0603 | 1 | 0603WAF2700T5E | UniOhm | LCSC | C22966 | Yes |  |  | Yes
45 | SDCARD MOLEX 1040310811 | SD | 1040310811 | 1 |  |  | MOLEX | 1040310811
46 | 1.25T-8A_C722648 | SPI | CONN-TH_1.25T-8A | 1 | 1.25T-8A | CAX | LCSC | C722648 | Yes
47 | B3U-1000P | RST,SW1 | KEY-SMD_B3U-1000PM | 2 | B3U-1000P | Omron Electronics | LCSC | C231329 | Yes | smtWeld | expand
48 | 4pad | SWD,UART | PAD 4 | 2 |  |  |  | N/A
49 | TCAN330GDCNR | U1 | SOT-23-8_L3.0-W1.7-P0.65-LS2.8-BL | 1 | TCAN330GDCNR | Texas Instruments | LCSC | C191006
50 | STM32L476RGT6 | U2 | LQFP-64_L10.0-W10.0-P0.50-LS12.0-BL | 1 | STM32L476RGT6 | STMicroelectronics | LCSC | C74797 | Yes |  |  | Yes
51 | XC6206P332MR | U3 | SOT-23-3_L2.9-W1.6-P1.90-LS2.8-BR | 1 | XC6206P332MR | TOREX | LCSC | C5446 | Yes |  |  | Yes
52 | SN74LV4052APW | U5 | TSSOP-16_L5.0-W4.4-P0.65-LS6.4-BL | 1 | SN74LV4052APW | VISHAY | LCSC | C145484 | Yes |  |  | Yes
53 | MAX3222EIPWR | U4,U6 | TSSOP-20_L6.5-W4.4-P0.65-LS6.4-BL | 2 | MAX3222EIPWR | Texas Instruments | LCSC | C527703 | Yes | smtWeld | expand | Yes
54 | LMV358B-VR | U7 | MSOP-8_L3.0-W3.0-P0.65-LS5.0-BL | 1 | LMV358B-VR | 3PEAK | LCSC | C248568
55 | BME280 | U8 | LGA-8_BME280_BR | 1 | BME280 | Bosch | LCSC | C92489 |  |  |  | Yes
56 | BMX160 | U9 | LGA-14_L3.0-W2.5-P0.50-BL | 1 | BMI160 | Bosch | Digi-Key | 828-1087-1-ND
57 | APDS-9250 | U10 | ADPS-9250 | 1 | APDS-9250
58 | AS3935 | U11 | 16LDMLPQ | 1
59 | 1.25T-1-4A | CAN,UART1,UART2 | CONN-TH_1.25T-1-4A | 3 | 1.25T-1-4A | BOOMELE | LCSC | C10821 | Yes
60 | 47346-0001 | USB | MICRO-USB-SMD_47346-0001 | 1 | 47346-0001 | MOLEX | LCSC | C132560
61 | 4.7uF | C14,VBAT | C0603 | 2 | CL10A475KO8NNNC | SAMSUNG | LCSC | C19666 | Yes |  |  | Yes
62 | 32.768KHz | X1 | OSC-SMD_L2.0-W1.2 | 1 | SC-20S32.768kHz20PPM12.5pF | SEIKO | LCSC | C97607
63 | 25M | X2 | OSC-SMD_4P-L3.2-W2.5-BL | 1 | 3S24000333 | Failong Crystal | LCSC | C427553
