shridattdudhat/Havaamaan_Yantra/Ref/QingStation-main/doc/figures/qing_assembly3.jpg

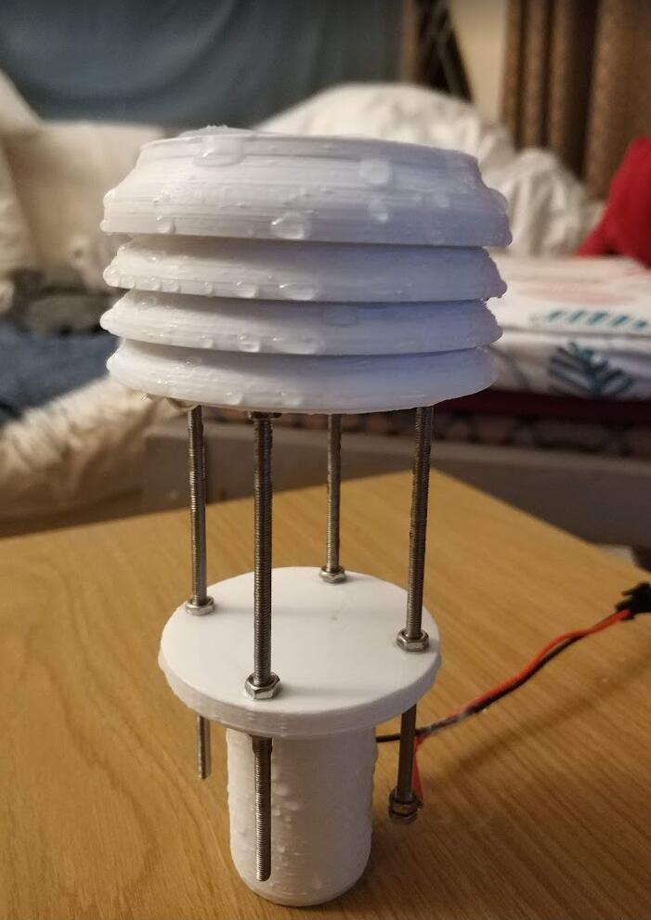
Ref/QingStation-main/doc/figures/qing_assembly3.jpg
