shridattdudhat/Havaamaan_Yantra/Ref/QingStation-main/doc/figures/rain_setup2.jpg

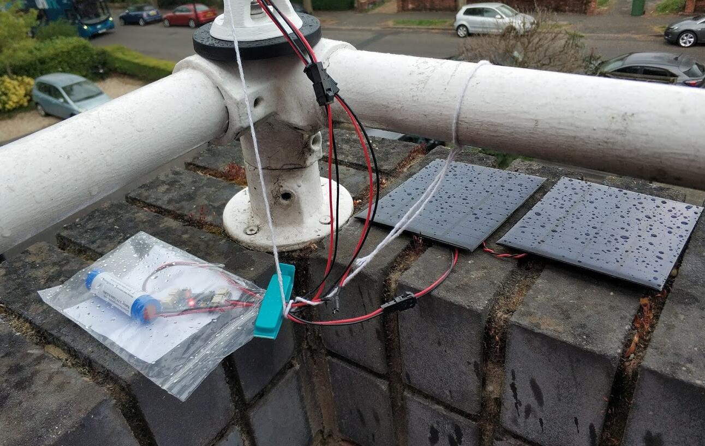
Ref/QingStation-main/doc/figures/rain_setup2.jpg
