shridattdudhat/Havaamaan_Yantra/Ref/QingStation-main/doc/figures/rain_setup3.jpg

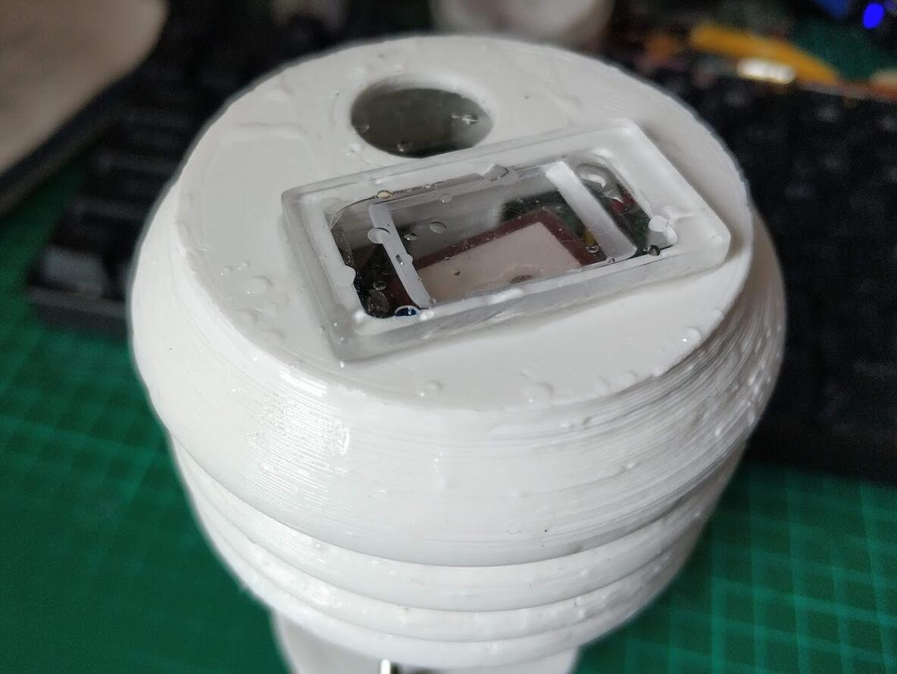
Ref/QingStation-main/doc/figures/rain_setup3.jpg
