shridattdudhat/Havaamaan_Yantra/Ref/QingStation-main/doc/figures/anemometer_car_experiment2.jpg

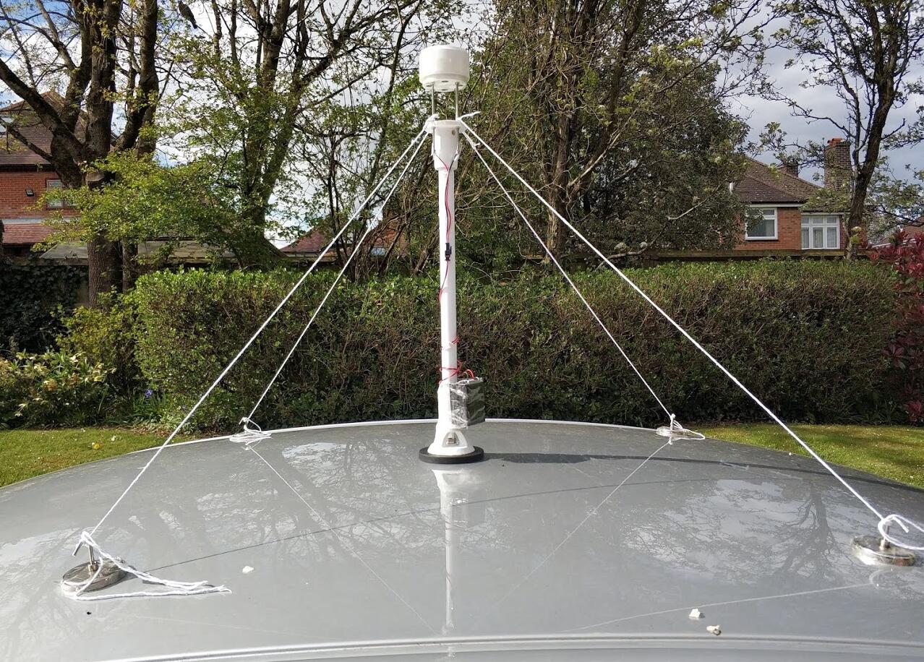
Ref/QingStation-main/doc/figures/anemometer_car_experiment2.jpg
