shridattdudhat/Havaamaan_Yantra/Ref/QingStation-main/doc/figures/anemometer_car_experiment3.jpg

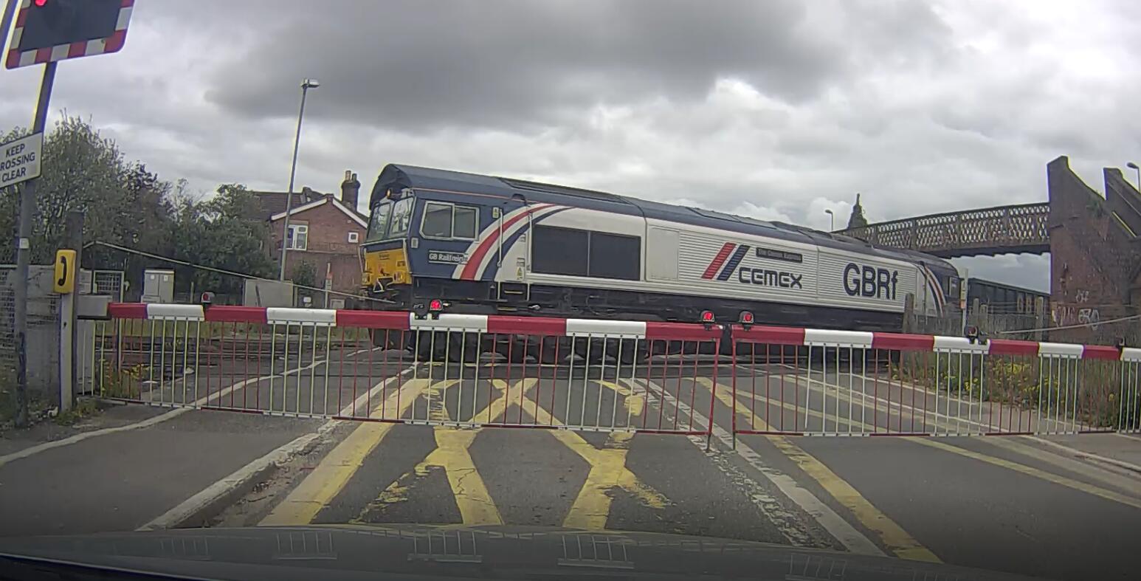
Ref/QingStation-main/doc/figures/anemometer_car_experiment3.jpg
