shridattdudhat/Havaamaan_Yantra/Ref/QingStation-main/doc/figures/anemometer_windspeed_measurement.png

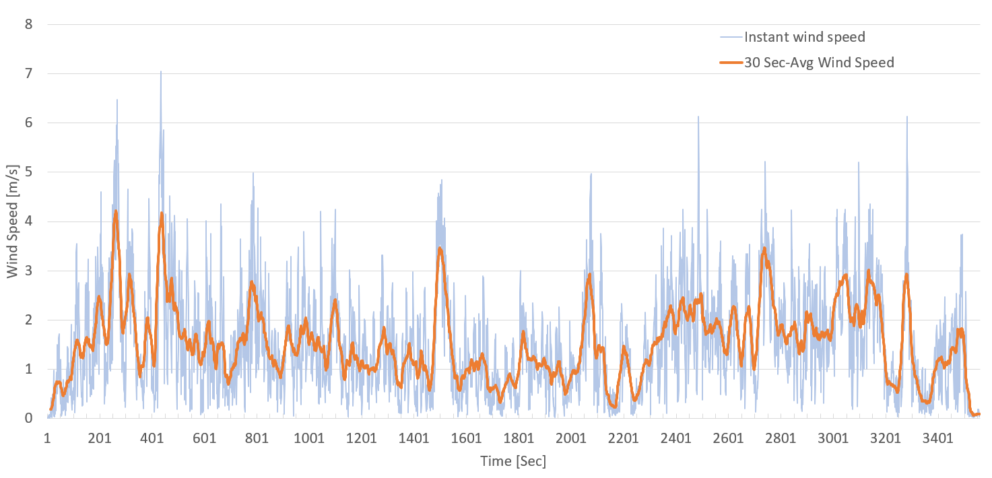
Ref/QingStation-main/doc/figures/anemometer_windspeed_measurement.png
