shridattdudhat/Havaamaan_Yantra/Ref/QingStation-main/doc/figures/first_windspeed_measurement.png

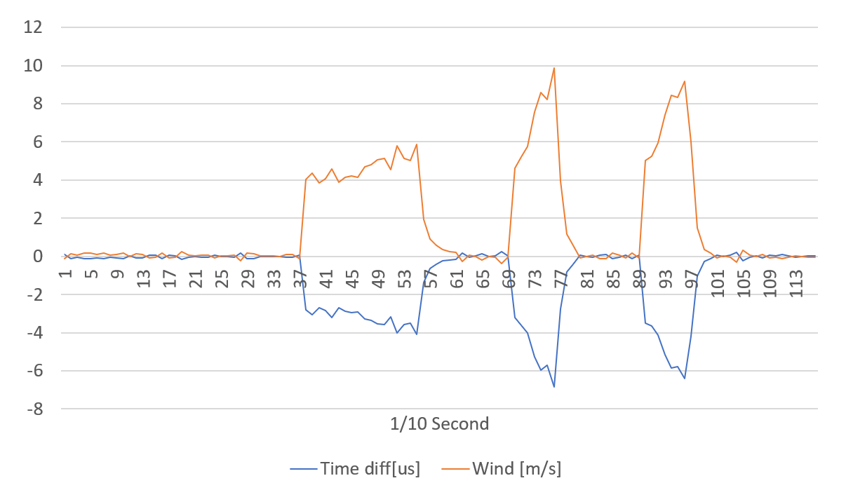
Ref/QingStation-main/doc/figures/first_windspeed_measurement.png
