shridattdudhat/Havaamaan_Yantra/Ref/QingStation-main/doc/figures/rain_calibration_setup.jpg

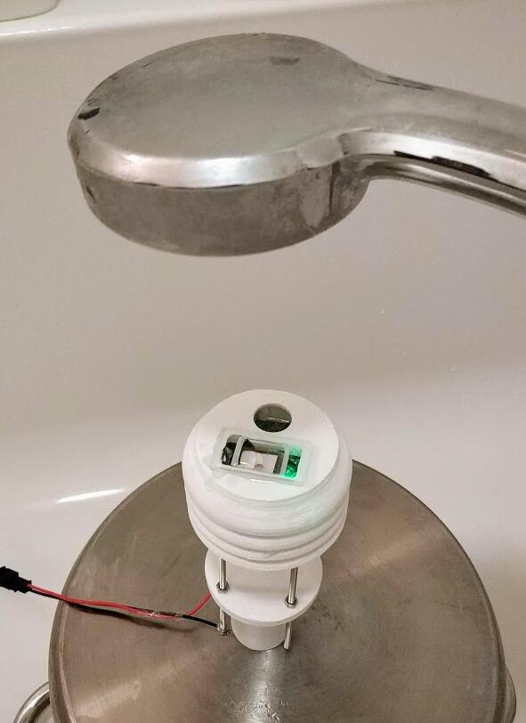
Ref/QingStation-main/doc/figures/rain_calibration_setup.jpg
