shridattdudhat/Havaamaan_Yantra/Ref/QingStation-main/doc/figures/rain_experiments.png

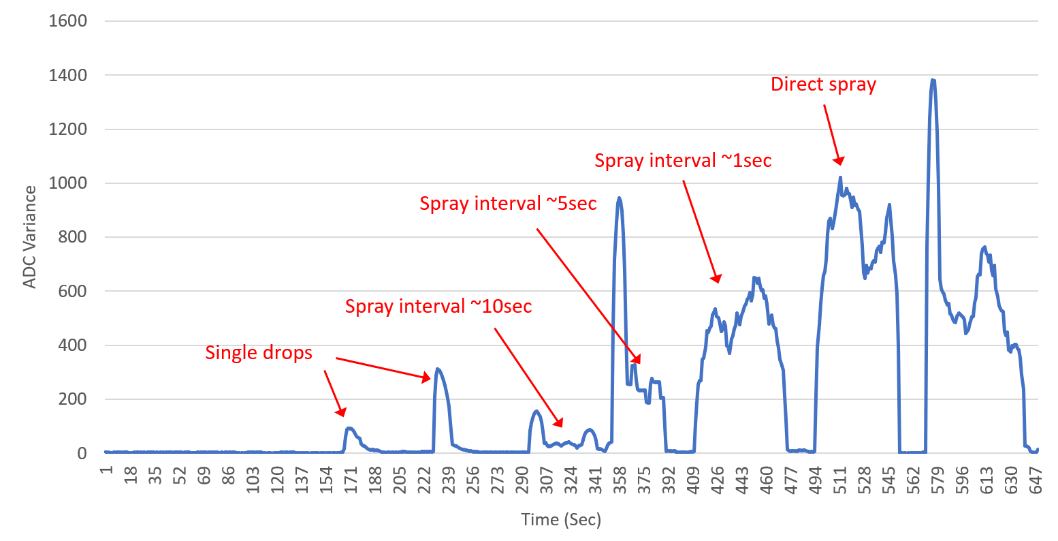
Ref/QingStation-main/doc/figures/rain_experiments.png
