shridattdudhat/Havaamaan_Yantra/hardware/HY_Annometer_v1/HY_Annometer_v1.kicad_pcb

## KiCad design hardware/HY_Annometer_v1/HY_Annometer_v1.kicad_pcb (2023-02-11)

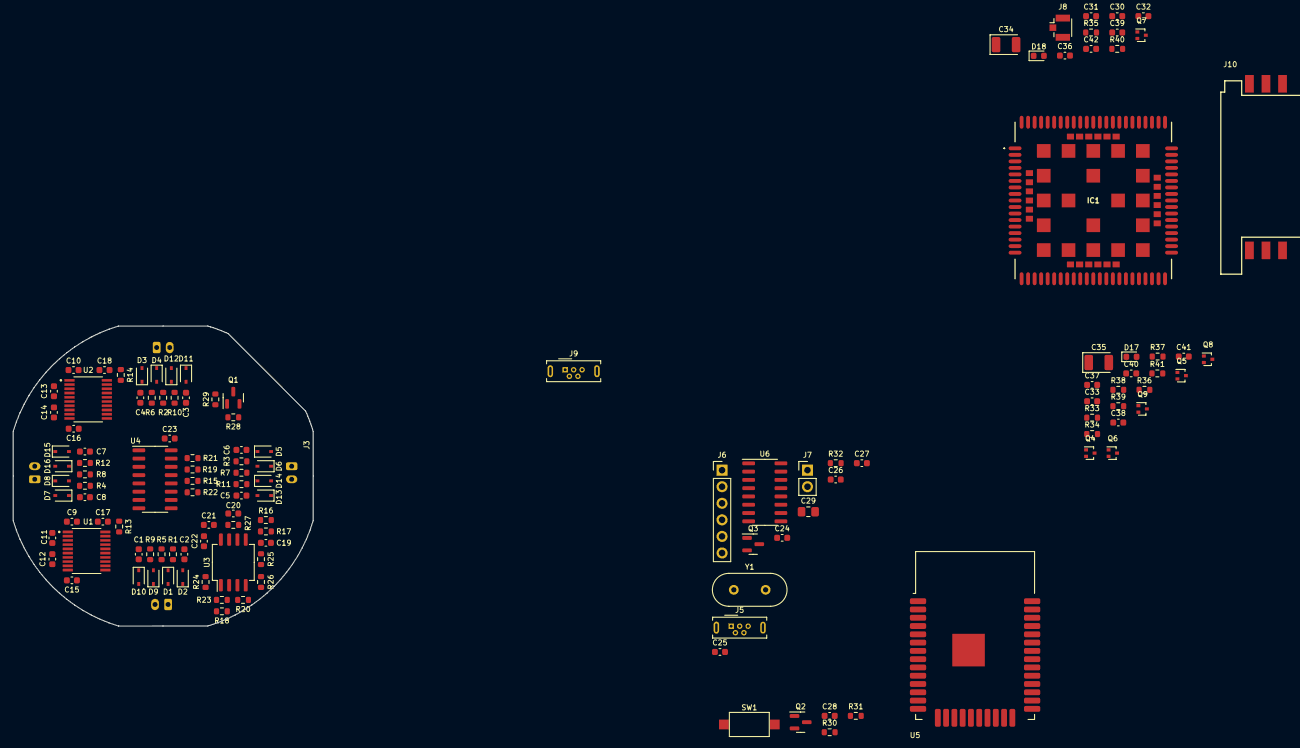
[picture p80: board HY_Annometer_v1.kicad_pcb from above]

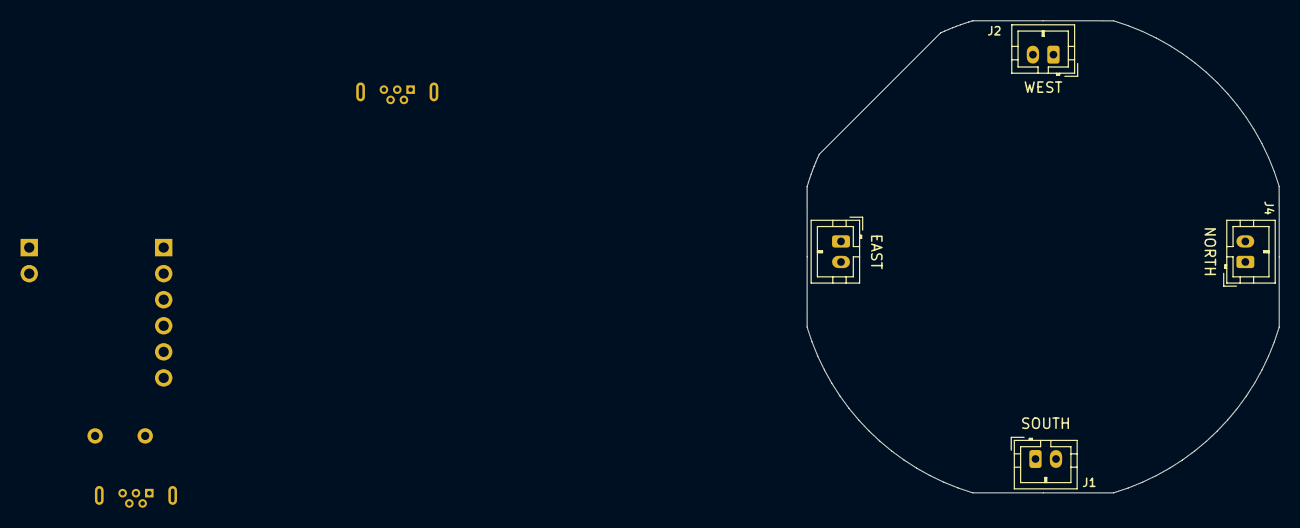
[picture p81: board HY_Annometer_v1.kicad_pcb from below]

Board: 2 copper layers, 46.0 x 46.0 mm, 129 parts (4 on the bottom side), 88 nets, no tracks yet.

Parts:
C1, C3, C5, C7, C33: 1uF; C_0603_1608Metric
C2, C4, C6, C8, C22, C23, C24, C27, C28, C32, C41, C42: 100nF; C_0603_1608Metric
C9, C10, C11, C12, C13, C14, C15, C16, C17, C18: 2.2uF; C_0603_1608Metric
C19, C21: 4.7uF; C_0603_1608Metric
C20, C25, C26: 22pF; C_0603_1608Metric
C29: 22uF; C_0805_2012Metric_Pad1.18x1.45mm_HandSolder
C30: 10pF; C_0603_1608Metric
C31, C36, C37, C38, C39, C40: 33pF; C_0603_1608Metric
C34, C35: 100uF; CP_EIA-3528-15_AVX-H
D1, D2, D3, D4, D5, D6, D7, D8, D9, D10, D11, D12, D13, D14, D15, D16: 1N4148WS; D_SOD-323
D17, D18: LED; LED_0603_1608Metric
IC1: A7672S_G; A7672X_Update
J1, J2, J3, J4: Conn_01x02; JST_PH_B2B-PH-K_1x02_P2.00mm_Vertical
J5, J9: USB_B_Micro; USB_Micro-B_Wuerth_614105150721_Vertical
J6: FTDI; PinHeader_1x06_P2.54mm_Vertical
J7: Conn_01x02; PinHeader_1x02_P2.54mm_Vertical
J8: Conn_Coaxial; U.FL_Hirose_U.FL-R-SMT-1_Vertical
J10: SIM5060-6-0-26-00-X_REVC; GCT_SIM5060-6-0-26-00-X_REVC_Update
Q1: Si2371EDS; SOT-23
Q2, Q3: MMBT5550L; SOT-23
Q4, Q5, Q6, Q7, Q8, Q9: DTC143Z; SOT-416
R1, R2, R3, R4, R20, R24, R26, R29: 4.7K; R_0603_1608Metric
R5, R6, R7, R8, R9, R10, R11, R12, R15, R19, R21, R22, R23, R30, R31, R32, R37, R41: 10K; R_0603_1608Metric
R13, R14, R16, R17, R25, R27, R28: 100K; R_0603_1608Metric
R18: 33R; R_0603_1608Metric
R33, R36: 1K; R_0603_1608Metric
R34, R35: 0R; R_0603_1608Metric
R38, R39, R40: 22; R_0603_1608Metric
SW1: RESET; SW_SPST_CK_RS282G05A3
U1, U2: MAX3222EIPWR; SOP65P640X120-20N
U3: LMV358; SO-8_5.3x6.2mm_P1.27mm
U4: 4052; SOIC-16_3.9x9.9mm_P1.27mm
U5: ESP32-WROOM-32D; ESP32-WROOM-32_ex
U6: CH340C; SOIC-16_3.9x9.9mm_P1.27mm
Y1: 12MHz; Crystal_HC49-4H_Vertical

Connections:
+1V8: IC1.15 (VDD__1V8), Q6.1 (B), Q8.1 (B)
+3.3V: C17.1, C18.1, C23.2, Q1.2 (S), R28.1, U1.19 (VCC), U2.19 (VCC), U4.16 (VDD)
+3.3VP: C21.2, C22.2, Q1.3 (D), U3.8 (V+)
+3V3: C27.2, C28.1, C29.1, J6.1, R30.2, R37.2, R41.2, U5.2 (VDD), U6.4 (V3), U6.16 (VCC)
+3V8: C30.2, C31.2, C32.2, C33.2, C34.1, C35.1, IC1.55 (VBAT), IC1.56 (VBAT), IC1.57 (VBAT), R33.2, R36.2
/Anemometer/VGND: C19.2, R16.2, R17.1, R20.1, R25.2, R26.1
DTR: J6.5, Q3.2 (E), R31.1, U6.13 (~DTR)
EAST: C7.2, U2.8 (DOUT2)
EAST_DRV0: R22.1, U2.12 (DIN2), U4.11 (X3)
EAST_IN: C8.2, U4.5 (Y1)
ECHO_OUT: C20.2, R27.1, U3.7
GND: C9.2, C10.2, C15.2, C16.2, C17.2, C18.2, C19.1, C21.1, C22.1, C23.1, C24.2, C25.1, C26.1, C27.1, C28.2, C29.2, C30.1, C31.1, C32.1, C33.1, C34.2, C35.2, C36.1, C37.1, C38.1, C39.1, C40.1, C41.1, C42.1, D1.2 (A), D2.1 (K), D3.2 (A), D4.1 (K), D5.2 (A), D6.1 (K), D7.2 (A), D8.1 (K), IC1.2 (GND), IC1.17 (GND), IC1.18 (GND), IC1.29 (GND), IC1.39 (GND), IC1.45 (GND), IC1.46 (GND), IC1.54 (GND), IC1.58 (GND), IC1.59 (GND), IC1.61 (GND), IC1.62 (GND), IC1.63 (GND), IC1.64 (GND), IC1.65 (GND), IC1.69 (GND), IC1.70 (GND), IC1.71 (GND), IC1.72 (GND), IC1.73 (GND), IC1.74 (GND), IC1.75 (GND), IC1.76 (GND), IC1.77 (GND), IC1.78 (GND), IC1.79 (GND), IC1.80 (GND), IC1.81 (GND), IC1.82 (GND), IC1.83 (GND), IC1.84 (GND), IC1.85 (GND), IC1.86 (GND), IC1.87 (GND), IC1.88 (GND), IC1.89 (GND), IC1.91 (GND), IC1.92 (GND), IC1.94 (GND), J1.1, J2.1, J3.1, J4.1, J5.5 (GND), J6.2, J7.2, J8.2 (Ext), J9.5 (GND), J10.C5 (GND), Q4.2 (E), Q5.2 (E), Q7.2 (E), Q9.2 (E), R5.1, R6.1, R7.1, R8.1, R9.1, R10.1, R11.1, R12.1, R13.1, R14.1, R15.2, R17.2, R19.2, R21.2, R22.2, SW1.2, U1.1 (~EN), U1.18 (GND), U2.1 (~EN), U2.18 (GND), U3.4 (V-), U4.7 (VEE), U4.8 (VSS), U5.1 (GND), U5.15 (GND), U5.38 (GND), U5.39 (GND), U6.1 (GND)
IO0: J7.1, Q3.3 (C), U5.25 (IO0)
LTE_RXD: IC1.10 (RXD), Q8.3 (C)
LTE_RXD_3V3: Q8.2 (E), R35.1, R41.1
LTE_TXD: IC1.9 (TXD), Q6.2 (E)
LTE_TXD_3V3: Q6.3 (C), R34.1, R37.1
NETLIGHT: IC1.52 (NETLIGHT), Q5.1 (B)
NORTH: C5.2, U2.17 (DOUT1)
NORTH_DRV0: R21.1, U2.13 (DIN1), U4.15 (X2)
NORTH_IN: C6.2, U4.1 (Y0)
unnamed: C1.1, D9.2 (A), D10.1 (K), R9.2
unnamed: C2.1, D1.1 (K), D2.2 (A), R1.1
unnamed: C3.1, D11.2 (A), D12.1 (K), R10.2
unnamed: C4.1, D3.1 (K), D4.2 (A), R2.1
unnamed: C5.1, D13.2 (A), D14.1 (K), R11.2
unnamed: C6.1, D5.1 (K), D6.2 (A), R3.1
unnamed: C7.1, D15.2 (A), D16.1 (K), R12.2
unnamed: C8.1, D7.1 (K), D8.2 (A), R4.1
unnamed: C9.1, U1.3 (V+)
unnamed: C10.1, U2.3 (V+)
unnamed: C11.1, U1.2 (C1+)
unnamed: C11.2, U1.4 (C1-)
unnamed: C12.1, U1.5 (C2+)
unnamed: C12.2, U1.6 (C2-)
unnamed: C13.1, U2.2 (C1+)
unnamed: C13.2, U2.4 (C1-)
unnamed: C14.1, U2.5 (C2+)
unnamed: C14.2, U2.6 (C2-)
unnamed: C15.1, U1.7 (V-)
unnamed: C16.1, U2.7 (V-)
unnamed: C20.1, R24.2, R27.2, U3.6 (-)
unnamed: C25.2, U6.7 (XI), Y1.1
unnamed: C26.2, U6.8 (XO), Y1.2
unnamed: D9.1 (K), D10.2 (A), J1.2, R1.2, R5.2
unnamed: D11.1 (K), D12.2 (A), J2.2, R2.2, R6.2
unnamed: D13.1 (K), D14.2 (A), J3.2, R3.2, R7.2
unnamed: D15.1 (K), D16.2 (A), J4.2, R4.2, R8.2
unnamed: D17.1 (K), Q4.3 (C)
unnamed: D17.2 (A), R33.1
unnamed: D18.1 (K), Q5.3 (C)
unnamed: D18.2 (A), R36.1
unnamed: IC1.60 (RF_ANT), J8.1 (In)
unnamed: J5.2 (D-), U6.6 (UD-)
unnamed: J5.3 (D+), U6.5 (UD+)
unnamed: J10.C2 (RST), R38.2
unnamed: J10.C3 (CLK), R39.2
unnamed: J10.C7 (I/O), R40.2
unnamed: Q1.1 (G), R28.2, R29.1
unnamed: Q2.1 (B), R31.2
unnamed: Q3.1 (B), R32.2
unnamed: R18.2, R23.2, U3.2 (-)
unnamed: R20.2, U3.3 (+)
unnamed: R23.1, R24.1, U3.1
unnamed: R25.1, R26.2, U3.5 (+)
PWRKEY: C42.2, IC1.1 (PWRKEY), Q9.3 (C)
PWR_DRV0: R13.2, R14.2, U1.20 (~PWRDOWN), U2.20 (~PWRDOWN)
PWR_ON: R29.2, U4.6 (Inh)
RST: C24.1, Q2.3 (C), R30.1, SW1.1, U5.3 (EN)
RTS: J6.6, Q2.2 (E), R32.1, U6.14 (~RTS)
RXD: J6.4, U5.35 (TXD0/IO1), U6.3 (RXD)
SIM_DN: IC1.27 (USB_DP), J9.2 (D-)
SIM_DP: IC1.28 (USB_DN), J9.3 (D+)
SIM_RST: C41.2, IC1.16 (RESET), Q7.3 (C)
SIM_VUSB: IC1.24 (VBUS), J9.1 (VBUS)
SOUTH: C1.2, U1.17 (DOUT1)
SOUTH_DRV0: R15.1, U1.13 (DIN1), U4.12 (X0)
SOUTH_IN: C2.2, U4.2 (Y2)
STATUS: IC1.66 (STATUS), Q4.1 (B)
TXD: J6.3, U5.34 (RXD0/IO3), U6.2 (TXD)
USIM_CLK: C39.2, IC1.32 (USIM1_CLK), R39.1
USIM_DATA: C38.2, IC1.31 (USIM1_DATA), R40.1
USIM_RST: C40.2, IC1.33 (USIM1_RST), R38.1
USIM_VDD: C36.2, C37.2, IC1.30 (USIM1_VDD), J10.C1 (VCC)
WEST: C3.2, U1.8 (DOUT2)
WEST_DRV0: R19.1, U1.12 (DIN2), U4.14 (X1)
WEST_IN: C4.2, U4.4 (Y3)
Y: R18.1, U4.3 (Y)
